NavinSiHive/Paper-to-Chip/README.md

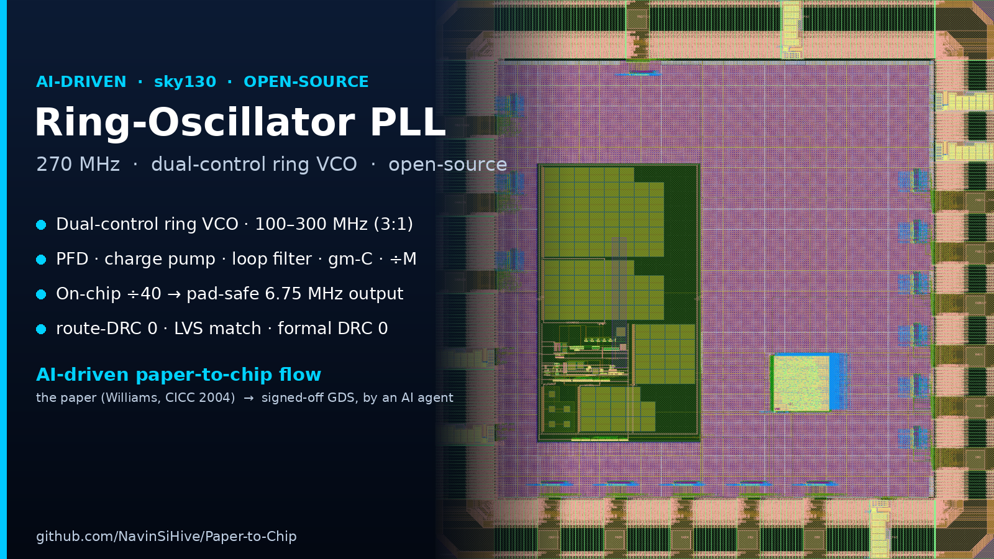
[picture p1: doc_images/pll_chip_banner.png]
Ring-Oscillator PLL — AI-driven paper-to-chip


# AI-driven Paper‑to‑Chip: an Open‑Source sky130 Ring‑Oscillator PLL






## 📖 The story behind this repo

We gave agentic AI a single input — a published IEEE PLL paper — and let it drive the
entire flow to a **clean sky130 mixed-signal chip**: circuit design, analog layout,
digital hardening (synth / STA / CTS / DFT), chip assembly, and DRC/LVS signoff. The
analog PLL macro (`PLLTOP4_D40`) **locks at 270 MHz across all corners with period
jitter under 5 ps**, DRC-clean and LVS-matched.

**→ Read the full write-up: https://si-hive.com/paper-to-chip**

**What's in here** (MIT-licensed): the chip and macro **GDS**, **behavioural + real-number
(RNM) models**, **schematics and symbols**, and the **signoff reports** (DRC / LVS / timing /
lock-detect). Study it, simulate the models (~2 min), reuse the blocks, retarget it to
another open PDK, or build on top — students, researchers, hobbyists, and startups welcome.

Built by **[Si-Hive](https://si-hive.com)** — AI-driven mixed-signal chip design.

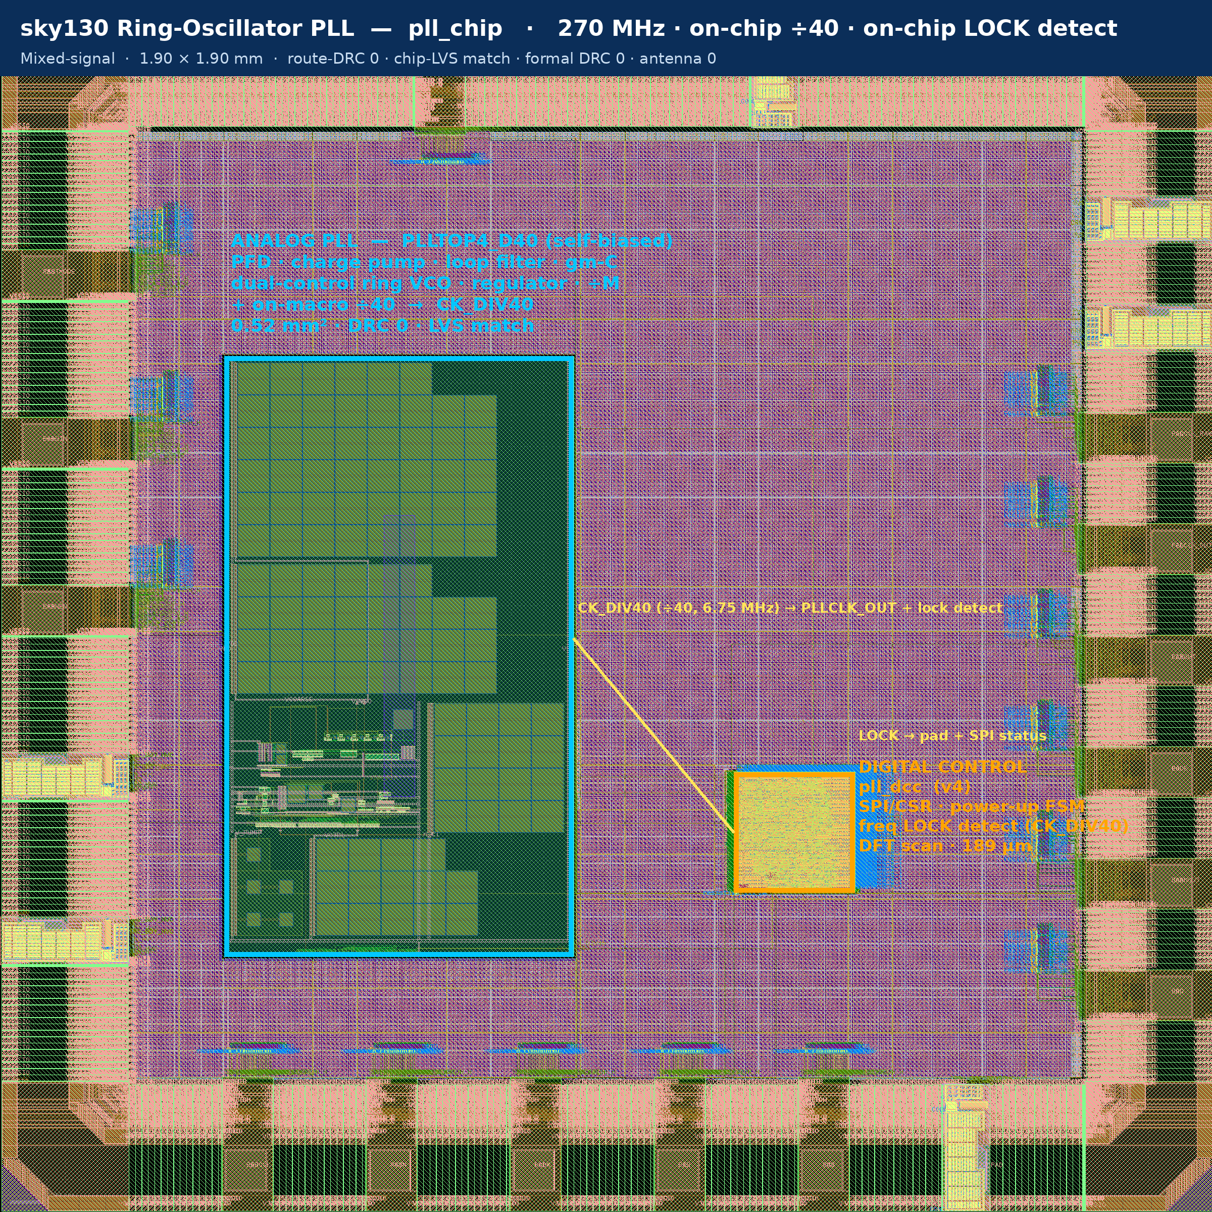
[picture p2: doc_images/pll_chip_snapshot.png]
PLL chip snapshot


*Final chip: self-biased analog PLL macro `PLLTOP4_D40` (left) + digital control `pll_dcc` (right) +
21‑pad IO ring. 1.90 × 1.90 mm, sky130. The analog macro divides its output by 40 on‑chip
(`CK_DIV40`, ~6.75 MHz) to a pad‑drivable rate.*

## Highlights
- **Full mixed‑signal chip**: analog PLL (PFD, charge pump, loop filter, gm‑C coarse path, dual‑control
  ring VCO, regulator, ÷M feedback) + a digital control/IO subsystem (SPI config, power‑up sequencing,
  lock detect, output‑clock management, DFT scan) + a sky130 pad ring.
- **Signed off**: route‑DRC 0 · chip‑LVS "match uniquely" · **formal DRC 0** (metal fill + standard
  hard‑IP waiver) · antenna 0 · multi‑corner STA clean (100–300 MHz).
- **On‑chip ÷40 output** (`CK_DIV40`): the ~270 MHz (≤300 MHz during lock) VCO clock is divided to
  ~6.75 MHz before the CMOS pad — sky130 has no LVDS, so the fast clock never leaves the analog.
- **Behavioral models included**: SystemVerilog (pre‑ and post‑layout) + a Real‑Number Model (RNM).

## Inside the analog PLL
The delivered analog macro **`PLLTOP4_D40`** is a self-biased **dual-control-path ring-oscillator PLL**
with an **on-chip ÷40** (pad-safe ≈ 6.75 MHz `CK_DIV40`). It builds up from the analog loop core outward —
**all three GDS are in [`gds/`](gds)** *(click any figure to zoom)*:

**`PLLTOP_AnaCore` — analog loop core** · the active devices: PFD · charge pump · ring VCO · ÷M · regulator · bias (loop-filter caps external).

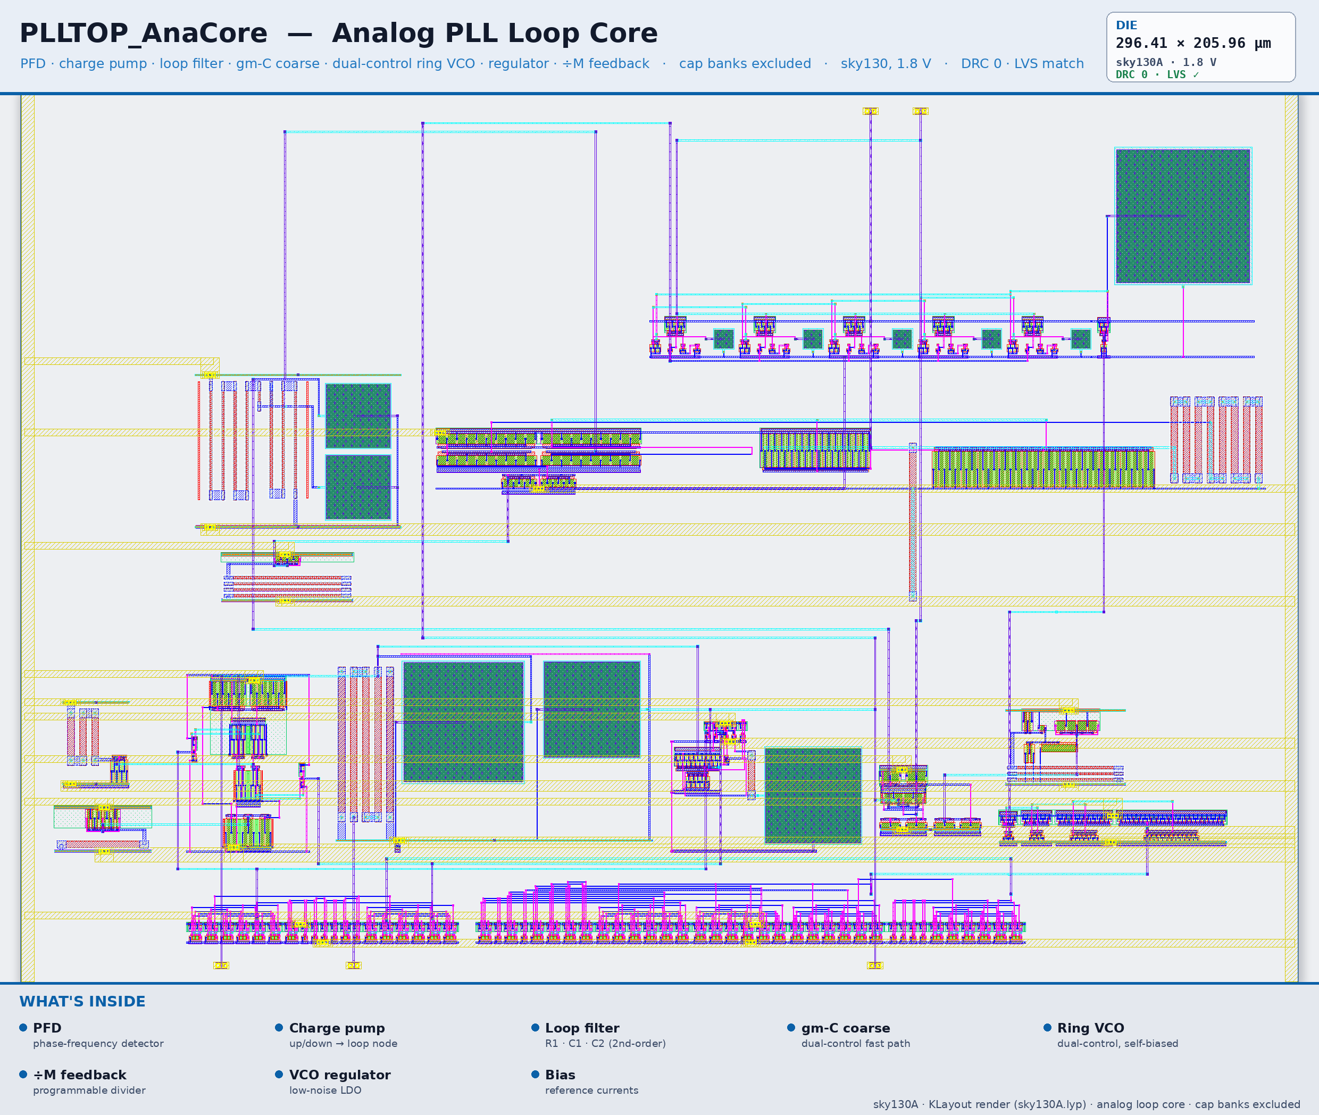
[picture p3: doc_images/PLLTOP_AnaCore.png]
PLLTOP_AnaCore


**`PLLTOP4` — PLL core** · the loop core plus the loop-filter / gm-C cap banks (no output divider).

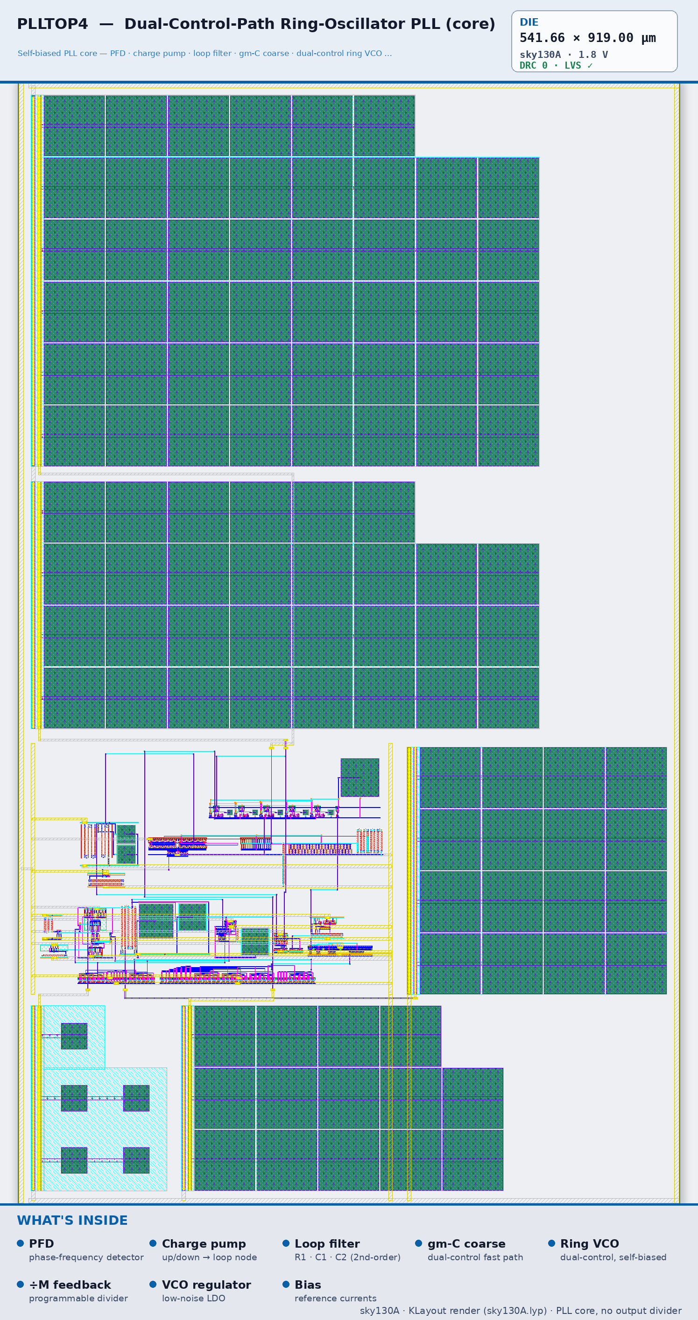
[picture p4: doc_images/PLLTOP4_layout.png]
PLLTOP4 core


**`PLLTOP4_D40` — delivered hard macro** · the PLL core + on-chip ÷40 (highlighted) → `CK_DIV40`.

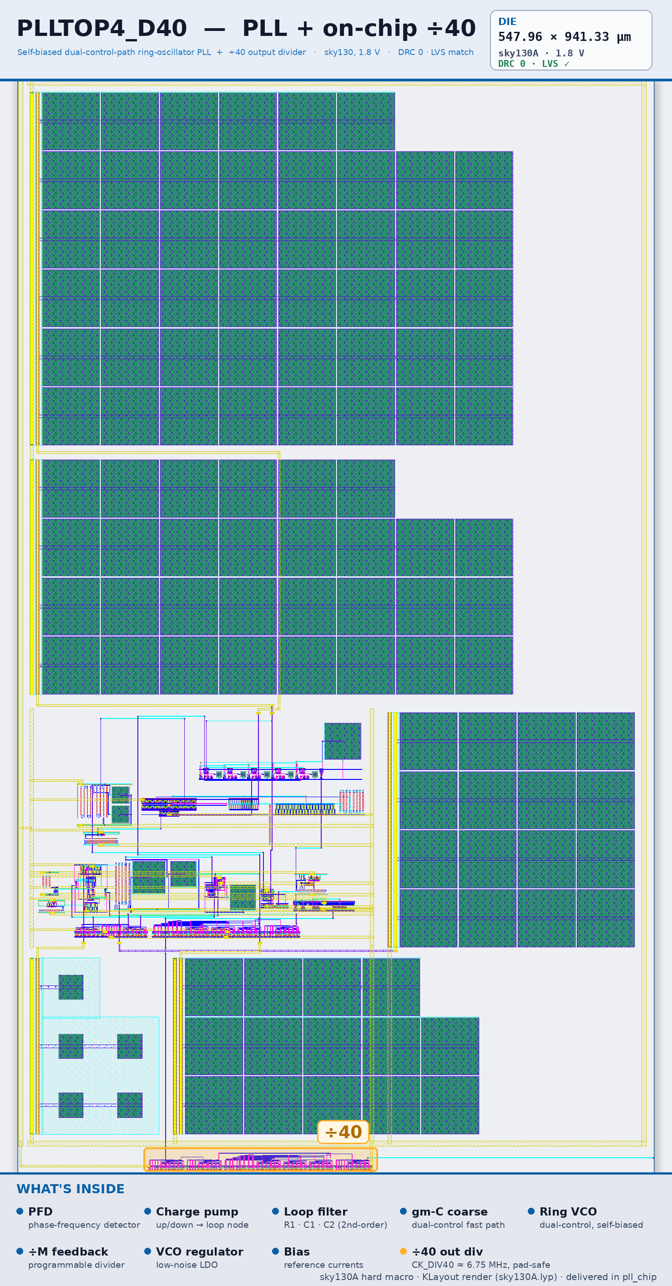
[picture p5: doc_images/PLLTOP4_D40_layout.png]
PLLTOP4_D40 macro


## Specs (nominal)
| Parameter | Value |
|---|---|
| Reference / output | 27 MHz → 270 MHz (÷M, M = 10) |
| Tuning range | 100 – 300 MHz (3:1, no band switching) |
| Output divider | ÷40 on‑macro → `CK_DIV40` ≈ 6.75 MHz |
| Supply / process | 1.8 V / sky130 (0.36 mm² analog, 1.90 × 1.90 mm chip) |

## Post-layout signoff (all corners)
| Corner | Lock | Period jitter (ps) |
|:---:|:---:|:---:|
| **TT** | 270 MHz | **1.96** |
| **SS** | 270 MHz | **0.60** |
| **FF** | 270 MHz | **2.30** |

All three corners lock at 270 MHz with period jitter **< 5 ps**.

### Lock witness — mixed-signal co-simulation
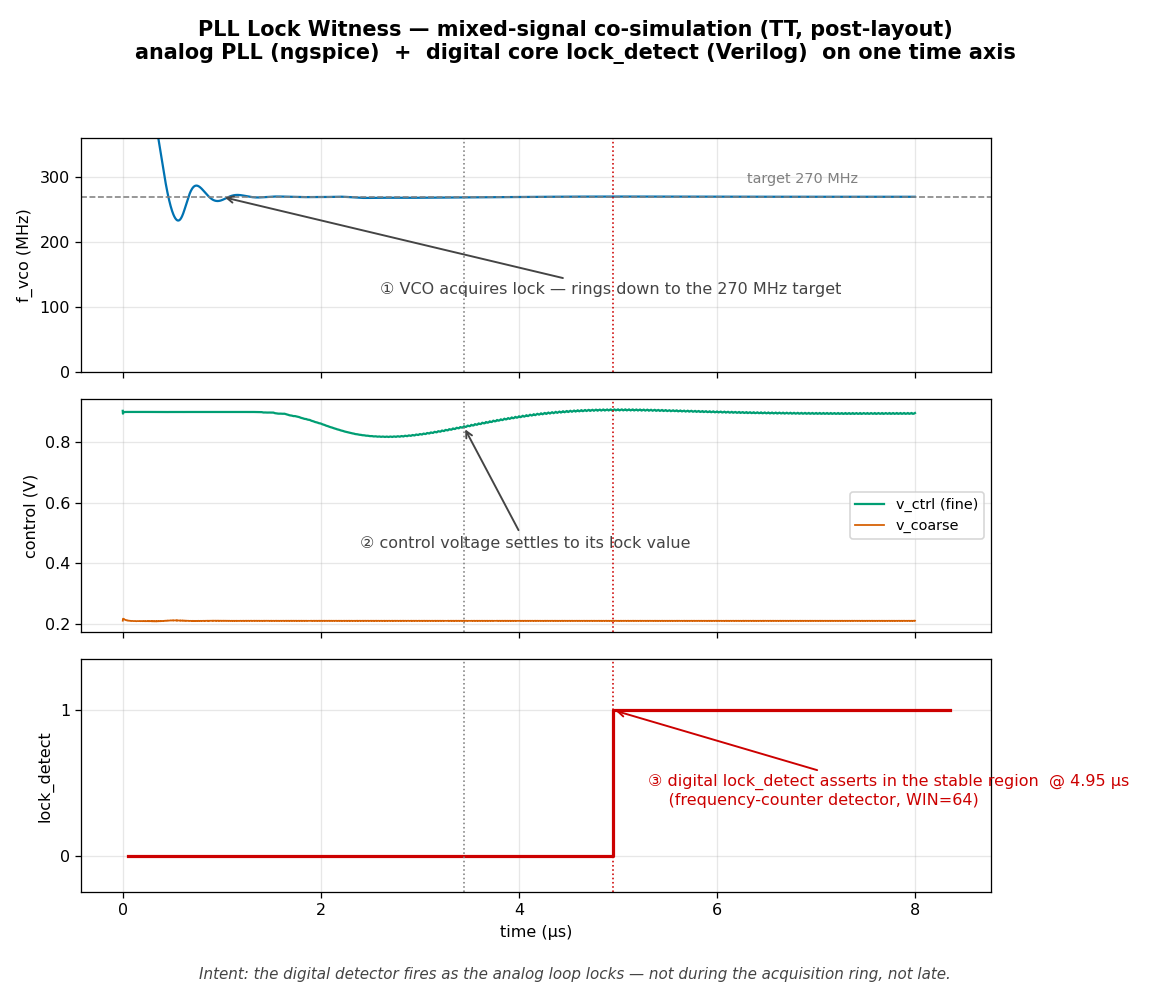
[picture p6: doc_images/pll_lock_witness.png]
PLL lock witness


*The analog PLL (ngspice) acquiring lock, with the digital core's `lock_detect` overlaid: `f_vco` rings
down to the 270 MHz target, the control voltage settles, and `lock_detect` asserts in the stable region
(~5 µs) — the digital detector witnessing the analog lock, on one time axis.*

## Repository layout
| Folder | Contents |
|---|---|
| [`gds/`](gds) | generated GDS (gz): chip · analog macro `PLLTOP4_D40` · PLL core `PLLTOP4` · loop core `PLLTOP_AnaCore` · digital core |
| [`schematics/`](schematics) | analog design schematics (xschem `.sch`) + device-level SPICE |
| [`symbols/`](symbols) | analog block symbols (xschem `.sym`) + macro abstracts (LEF) |
| [`models/`](models) | SystemVerilog (pre/post‑layout) + Real‑Number (RNM) models + testbench |
| [`cdl/`](cdl) | device‑level CDL / schematic netlists (for LVS) |
| [`reports/`](reports) | signoff reports — [`drc/`](reports/drc) · [`lvs/`](reports/lvs) · [`lock_detect/`](reports/lock_detect) · timing |
| [`docs/`](docs) | architecture, tapeout signoff summary |
| [`doc_images/`](doc_images) | chip + block layout images |

## Simulate the PLL model (2 minutes)
```bash
cd models && ./run_models.sh        # iverilog/Verilator: prelayout · postlayout · RNM → ALL_PASS
```
Checks: PLL_CLK locks to 270 MHz (±1 %), ÷M = 10.

## Use the GDS
```bash
gunzip gds/pll_chip.gds.gz          # open in KLayout / magic
```

## What is *not* here
The proprietary automated‑layout engine that generated the analog macro is intentionally excluded — this
repository ships the **generated artifacts** (GDS, models, docs) only. The analog PLL is delivered as a
verified hard macro.

## About & links
Built at **Si-Hive** — [si-hive.com](https://si-hive.com) · silicon design & EDA automation.

📖 **Full write-up:** [How this PLL went from paper to GDS with an AI design agent](https://si-hive.com/paper-to-chip)
— the corner results, the 100–300 MHz range, the lock-witness, and the open-source story.

💬 **Contact:** questions / collaboration → **assist@si-hive.com**, or open a GitHub issue.

## License
**MIT** (see [LICENSE](LICENSE)). Generated GDS, models, and docs are provided as‑is, without warranty.
