NavinSiHive/Paper-to-Chip/reports/lvs/README.md

# reports/lvs/
LVS reports. Chip-level hierarchical LVS (both macros black-boxed by port) = "Circuits match uniquely". Block-level LVS (PLLTOP_D40, pll_dcc) verified in their own flows.
