NavinSiHive/Paper-to-Chip/doc_images/phase3_ff_lock.png

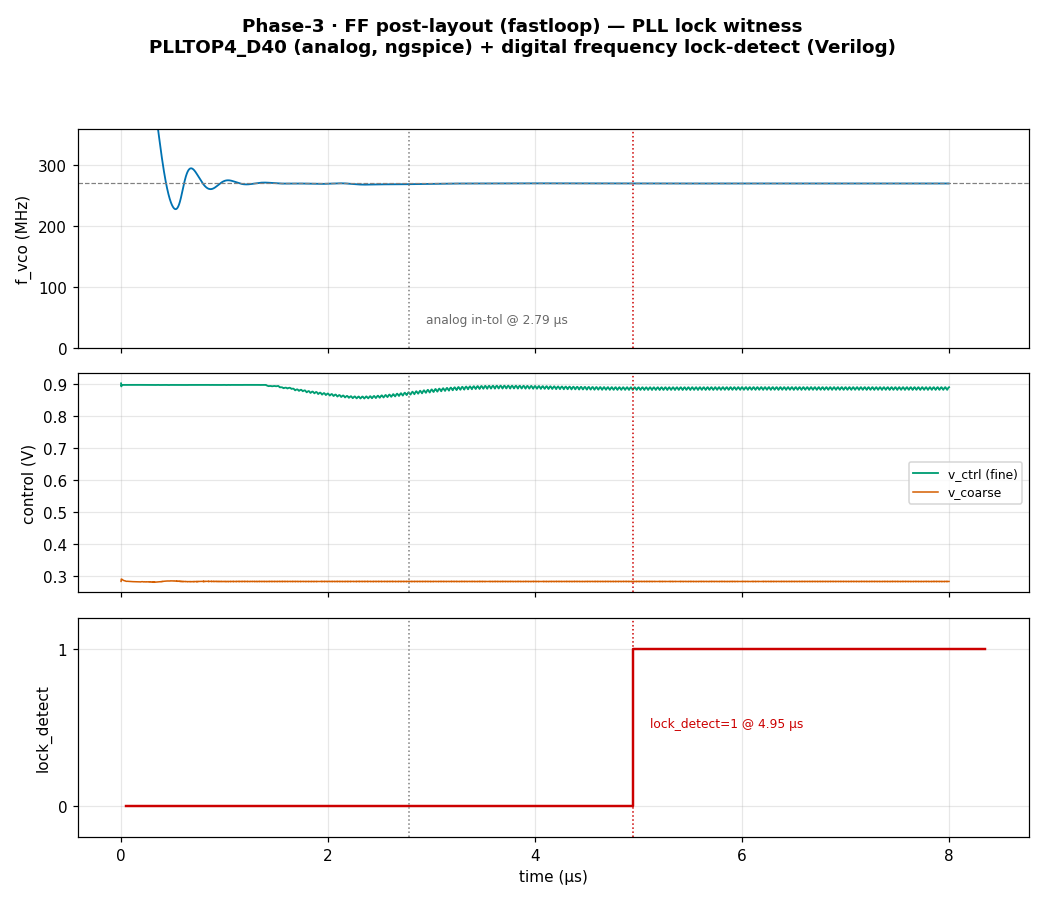
doc_images/phase3_ff_lock.png
