NavinSiHive/Paper-to-Chip/doc_images/phase3_ss_lock.png

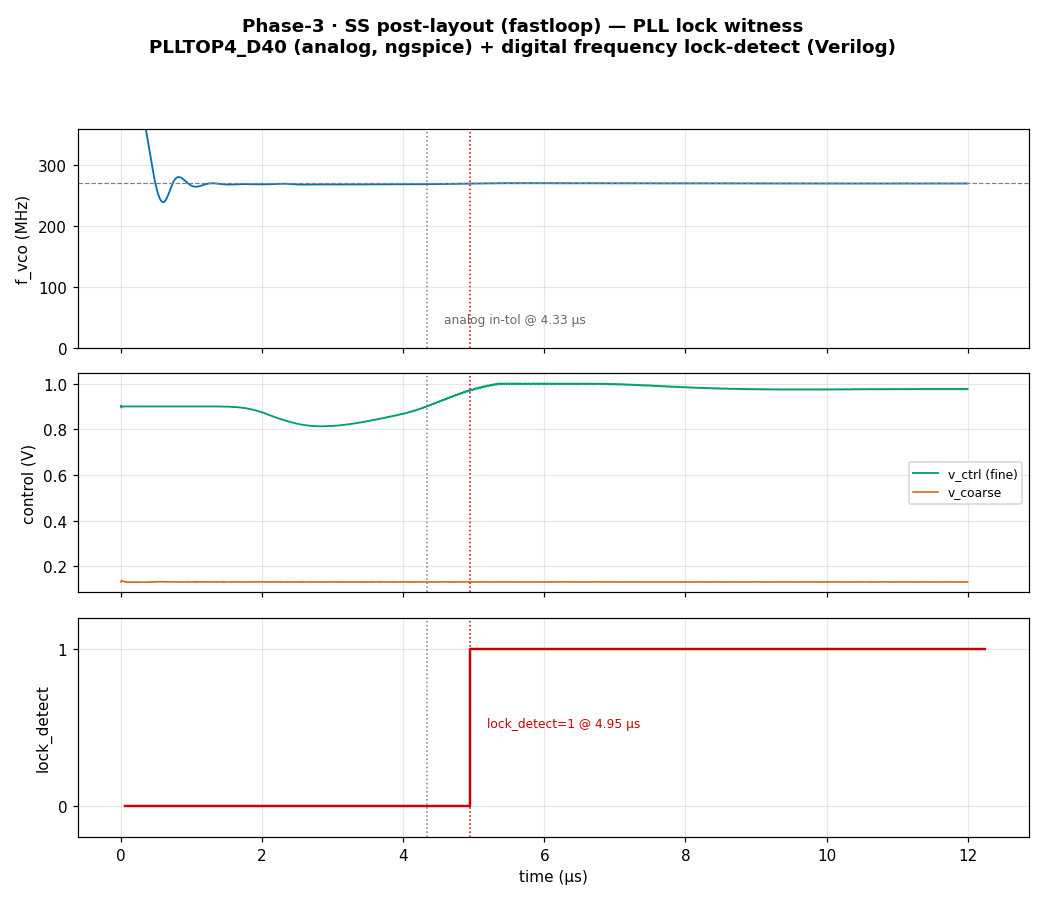
doc_images/phase3_ss_lock.png
