NavinSiHive/Paper-to-Chip/doc_images/phase3_tt_lock.png

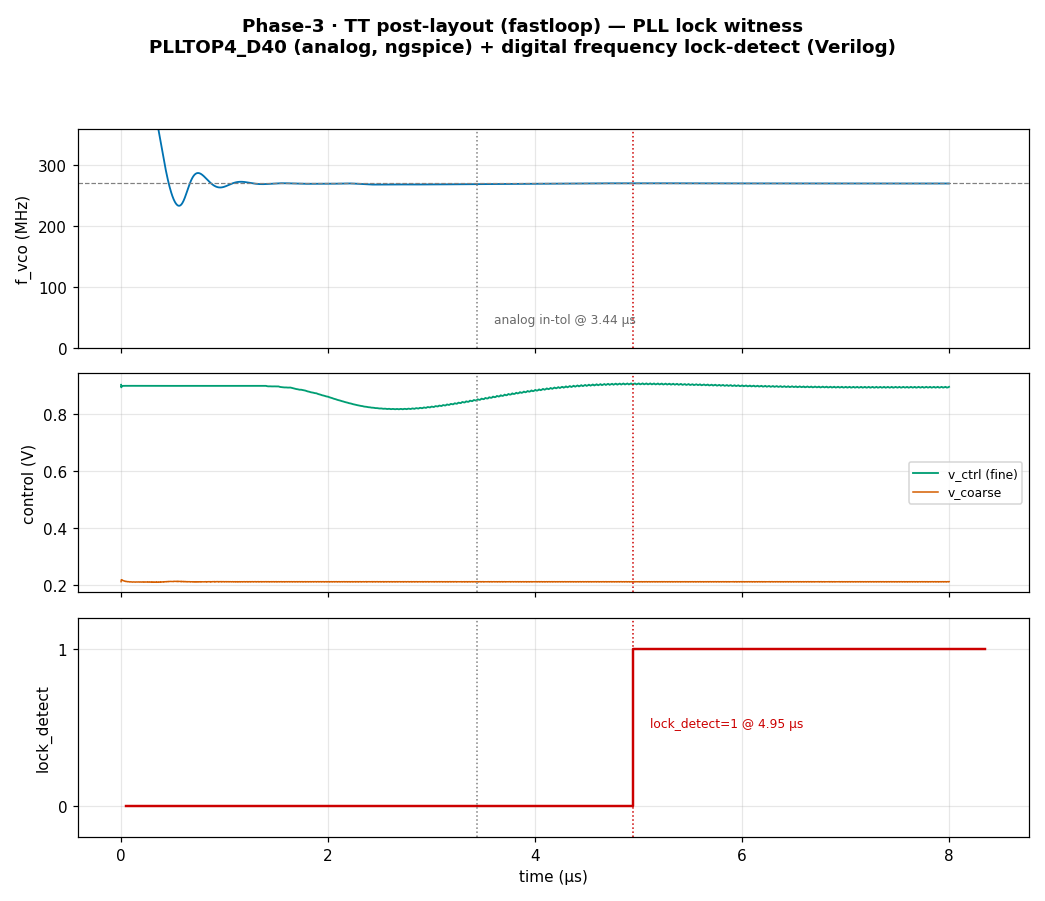
doc_images/phase3_tt_lock.png
