NavinSiHive/Paper-to-Chip/doc_images/pll_chip_final.png

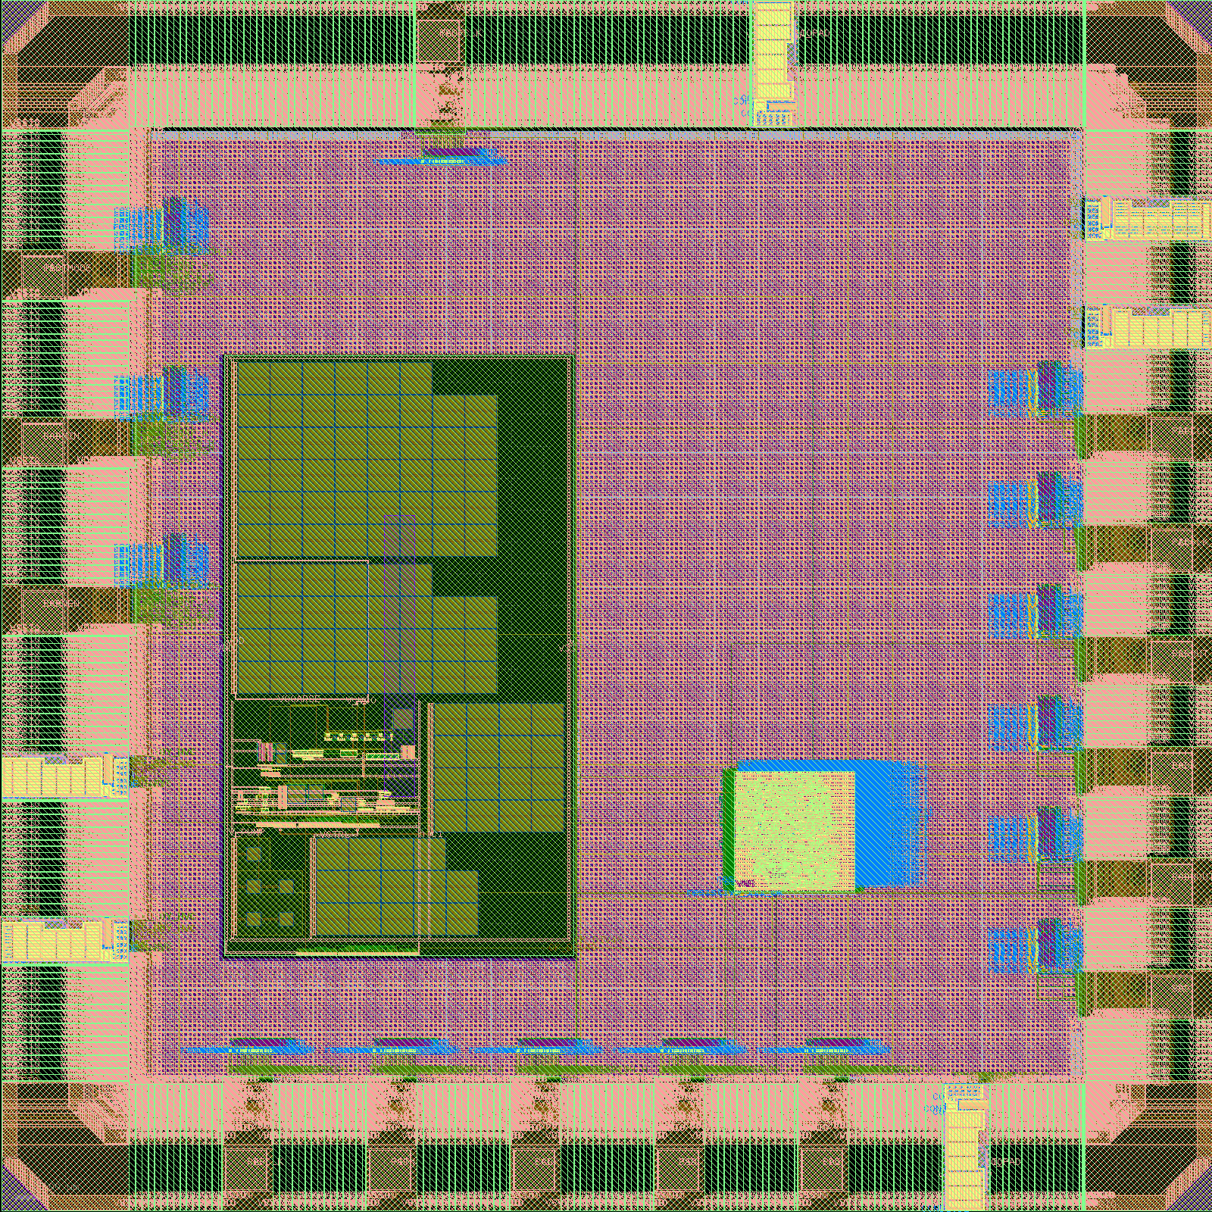
doc_images/pll_chip_final.png
