NavinSiHive/Paper-to-Chip/doc_images/pll_dcc_layout.png

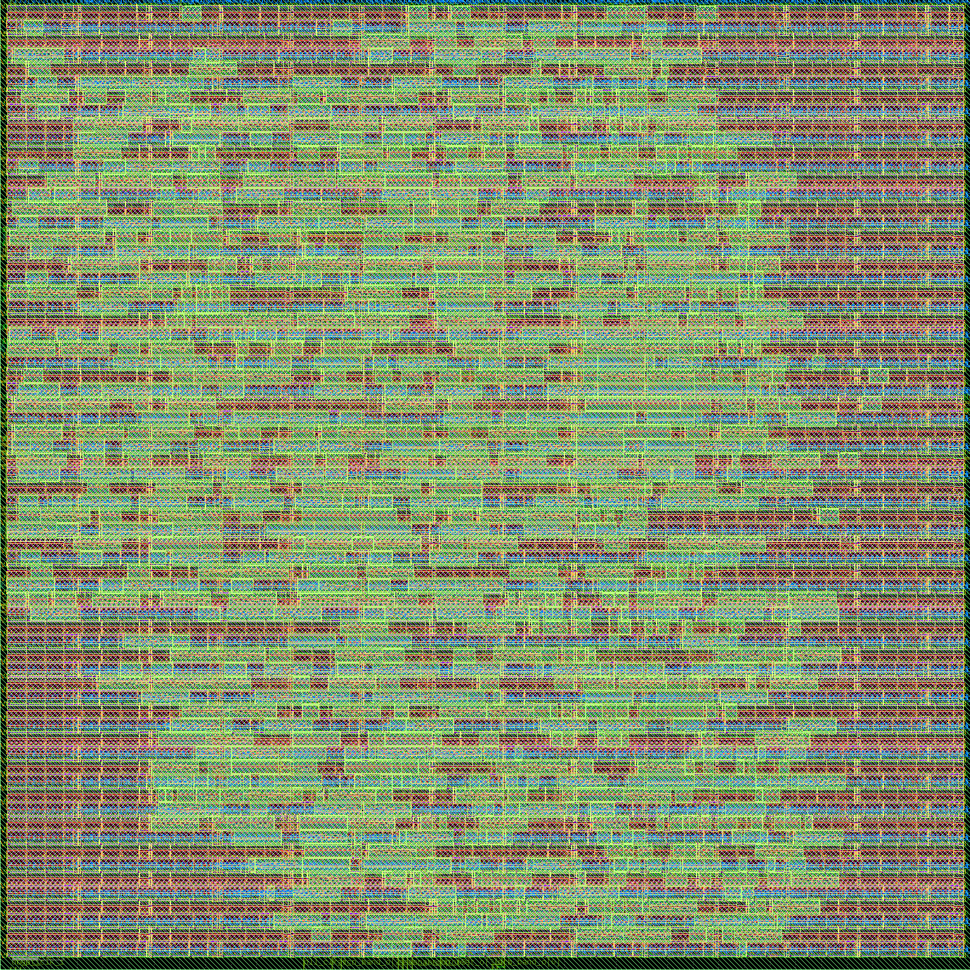
doc_images/pll_dcc_layout.png
