NavinSiHive/Paper-to-Chip/schematics/pll_dcc.gatelevel.v

module pll_dcc (clk_out_o,
    div_rst_o,
    dn_i,
    en_cp_o,
    en_vco_o,
    en_vreg_o,
    lock_o,
    pll_clk_i,
    pll_en_o,
    ref_o,
    refclk_i,
    rst_n_i,
    scan_en_i,
    scan_in_i,
    scan_out_o,
    spi_cs_n_i,
    spi_sclk_i,
    spi_sdi_i,
    spi_sdo_o,
    test_clk_i,
    test_mode_i,
    up_i,
    cp_iset_o,
    m_div_o,
    vco_band_o);
 output clk_out_o;
 output div_rst_o;
 input dn_i;
 output en_cp_o;
 output en_vco_o;
 output en_vreg_o;
 output lock_o;
 input pll_clk_i;
 output pll_en_o;
 output ref_o;
 input refclk_i;
 input rst_n_i;
 input scan_en_i;
 input scan_in_i;
 output scan_out_o;
 input spi_cs_n_i;
 input spi_sclk_i;
 input spi_sdi_i;
 output spi_sdo_o;
 input test_clk_i;
 input test_mode_i;
 input up_i;
 output [7:0] cp_iset_o;
 output [7:0] m_div_o;
 output [7:0] vco_band_o;

 wire pll_clk_i_regs;
 wire _0001_;
 wire _0002_;
 wire _0003_;
 wire _0004_;
 wire _0005_;
 wire _0006_;
 wire _0007_;
 wire _0008_;
 wire _0009_;
 wire _0010_;
 wire _0011_;
 wire _0012_;
 wire _0013_;
 wire _0014_;
 wire _0015_;
 wire _0016_;
 wire _0017_;
 wire _0018_;
 wire _0019_;
 wire _0020_;
 wire _0021_;
 wire _0022_;
 wire _0023_;
 wire _0024_;
 wire _0025_;
 wire _0026_;
 wire _0027_;
 wire _0028_;
 wire _0029_;
 wire _0030_;
 wire _0031_;
 wire _0032_;
 wire _0033_;
 wire _0034_;
 wire _0035_;
 wire _0036_;
 wire _0037_;
 wire _0038_;
 wire _0039_;
 wire _0040_;
 wire _0041_;
 wire _0042_;
 wire _0043_;
 wire _0044_;
 wire _0045_;
 wire _0046_;
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
 wire clknet_4_2_0_refclk_i_regs;
 wire clknet_4_3_0_refclk_i_regs;
 wire clknet_4_4_0_refclk_i_regs;
 wire clknet_4_5_0_refclk_i_regs;
 wire clknet_4_6_0_refclk_i_regs;
 wire clknet_4_7_0_refclk_i_regs;
 wire clknet_4_8_0_refclk_i_regs;
 wire clknet_4_9_0_refclk_i_regs;
 wire clknet_4_10_0_refclk_i_regs;
 wire clknet_4_11_0_refclk_i_regs;
 wire clknet_4_12_0_refclk_i_regs;
 wire clknet_4_13_0_refclk_i_regs;
 wire clknet_4_14_0_refclk_i_regs;
 wire clknet_4_15_0_refclk_i_regs;
 wire \clknet_0_u_clkout.sel_clk ;
 wire \clknet_1_0__leaf_u_clkout.sel_clk ;
 wire \clknet_0_u_clkout.sel_clk_regs ;
 wire \clknet_1_0__leaf_u_clkout.sel_clk_regs ;
 wire clknet_0_spi_sclk_i;
 wire clknet_3_0__leaf_spi_sclk_i;
 wire clknet_3_1__leaf_spi_sclk_i;
 wire clknet_3_2__leaf_spi_sclk_i;
 wire clknet_3_3__leaf_spi_sclk_i;
 wire clknet_3_4__leaf_spi_sclk_i;
 wire clknet_3_5__leaf_spi_sclk_i;
 wire clknet_3_6__leaf_spi_sclk_i;
 wire clknet_3_7__leaf_spi_sclk_i;
 wire clknet_0_pll_d2;
 wire clknet_1_0__leaf_pll_d2;
 wire clknet_1_1__leaf_pll_d2;
 wire delaynet_0_refclk;
 wire delaynet_1_refclk;
 wire delaynet_2_refclk;
 wire delaynet_3_refclk;
 wire delaynet_4_refclk;
 wire delaynet_5_refclk;
 wire delaynet_6_refclk;
 wire delaynet_7_refclk;

 sky130_fd_sc_hd__nand2_1 _0708_ (.A(\u_csr.bit_cnt[2] ),
    .B(_0012_),
    .Y(_0439_));
 sky130_fd_sc_hd__or2_2 _0709_ (.A(\u_csr.bit_cnt[3] ),
    .B(_0439_),
    .X(_0440_));
 sky130_fd_sc_hd__mux2_2 _0711_ (.A0(net6),
    .A1(net58),
    .S(_0440_),
    .X(_0190_));
 sky130_fd_sc_hd__mux2_2 _0714_ (.A0(\u_csr.shreg[0] ),
    .A1(\u_csr.addr_r[1] ),
    .S(_0440_),
    .X(_0189_));
 sky130_fd_sc_hd__mux2_2 _0716_ (.A0(\u_csr.shreg[1] ),
    .A1(\u_csr.addr_r[2] ),
    .S(_0440_),
    .X(_0188_));
 sky130_fd_sc_hd__mux2_2 _0718_ (.A0(\u_csr.shreg[2] ),
    .A1(\u_csr.addr_r[3] ),
    .S(_0440_),
    .X(_0187_));
 sky130_fd_sc_hd__mux2_2 _0720_ (.A0(\u_csr.shreg[3] ),
    .A1(\u_csr.addr_r[4] ),
    .S(_0440_),
    .X(_0186_));
 sky130_fd_sc_hd__mux2_2 _0722_ (.A0(\u_csr.shreg[4] ),
    .A1(\u_csr.addr_r[5] ),
    .S(_0440_),
    .X(_0185_));
 sky130_fd_sc_hd__inv_1 _0723_ (.A(\u_lock.bad_cnt[0] ),
    .Y(_0050_));
 sky130_fd_sc_hd__inv_1 _0724_ (.A(\u_clkout.N[2] ),
    .Y(_0014_));
 sky130_fd_sc_hd__inv_1 _0725_ (.A(\u_clkout.N[1] ),
    .Y(_0038_));
 sky130_fd_sc_hd__inv_1 _0726_ (.A(\u_lock.k_s[4] ),
    .Y(_0074_));
 sky130_fd_sc_hd__inv_1 _0727_ (.A(\u_lock.k_s[2] ),
    .Y(_0071_));
 sky130_fd_sc_hd__inv_1 _0728_ (.A(\u_lock.k_s[5] ),
    .Y(_0068_));
 sky130_fd_sc_hd__inv_1 _0729_ (.A(\u_lock.k_s[6] ),
    .Y(_0065_));
 sky130_fd_sc_hd__inv_1 _0730_ (.A(\c_seqdly[1] ),
    .Y(_0062_));
 sky130_fd_sc_hd__inv_1 _0731_ (.A(_0089_),
    .Y(_0448_));
 sky130_fd_sc_hd__nand2b_1 _0732_ (.A_N(_0033_),
    .B(_0032_),
    .Y(_0449_));
 sky130_fd_sc_hd__a21o_1 _0733_ (.A1(_0081_),
    .A2(_0449_),
    .B1(_0080_),
    .X(_0450_));
 sky130_fd_sc_hd__a21o_1 _0734_ (.A1(_0049_),
    .A2(_0450_),
    .B1(_0048_),
    .X(_0451_));
 sky130_fd_sc_hd__nor2_1 _0735_ (.A(_0448_),
    .B(_0451_),
    .Y(_0268_));
 sky130_fd_sc_hd__inv_1 _0736_ (.A(\u_clkout.cnt[0] ),
    .Y(_0030_));
 sky130_fd_sc_hd__nor2_1 _0737_ (.A(\u_clkout.cnt[0] ),
    .B(_0451_),
    .Y(_0267_));
 sky130_fd_sc_hd__nand3_1 _0738_ (.A(\u_csr.bit_cnt[2] ),
    .B(\u_csr.bit_cnt[1] ),
    .C(\u_csr.bit_cnt[0] ),
    .Y(_0452_));
 sky130_fd_sc_hd__xnor2_1 _0739_ (.A(\u_csr.bit_cnt[3] ),
    .B(_0452_),
    .Y(_0002_));
 sky130_fd_sc_hd__xor2_1 _0740_ (.A(\u_csr.bit_cnt[2] ),
    .B(_0013_),
    .X(_0001_));
 sky130_fd_sc_hd__nor3b_1 _0742_ (.A(\u_lock.win_cnt[14] ),
    .B(\u_lock.win_cnt[15] ),
    .C_N(_0017_),
    .Y(_0454_));
 sky130_fd_sc_hd__and3_1 _0743_ (.A(\u_lock.win_cnt[4] ),
    .B(\u_lock.win_cnt[3] ),
    .C(\u_lock.win_cnt[2] ),
    .X(_0455_));
 sky130_fd_sc_hd__and2_1 _0744_ (.A(\u_lock.win_cnt[5] ),
    .B(_0455_),
    .X(_0456_));
 sky130_fd_sc_hd__or4_1 _0745_ (.A(\u_lock.win_cnt[12] ),
    .B(\u_lock.win_cnt[13] ),
    .C(\u_lock.win_cnt[10] ),
    .D(\u_lock.win_cnt[11] ),
    .X(_0457_));
 sky130_fd_sc_hd__nand2_1 _0746_ (.A(\u_lock.win_cnt[7] ),
    .B(\u_lock.win_cnt[6] ),
    .Y(_0458_));
 sky130_fd_sc_hd__nor4_2 _0747_ (.A(\u_lock.win_cnt[9] ),
    .B(\u_lock.win_cnt[8] ),
    .C(_0457_),
    .D(_0458_),
    .Y(_0459_));
 sky130_fd_sc_hd__nand3_2 _0748_ (.A(_0454_),
    .B(_0456_),
    .C(_0459_),
    .Y(_0460_));
 sky130_fd_sc_hd__nand2_1 _0749_ (.A(\u_lock.u_en.q[0] ),
    .B(_0460_),
    .Y(_0461_));
 sky130_fd_sc_hd__nand2_1 _0752_ (.A(\u_lock.div_cnt[13] ),
    .B(\u_lock.div_cnt[12] ),
    .Y(_0464_));
 sky130_fd_sc_hd__and2_1 _0754_ (.A(\u_lock.div_cnt[11] ),
    .B(\u_lock.div_cnt[10] ),
    .X(_0466_));
 sky130_fd_sc_hd__and4_4 _0757_ (.A(\u_lock.div_cnt[5] ),
    .B(\u_lock.div_cnt[2] ),
    .C(\u_lock.div_cnt[4] ),
    .D(\u_lock.div_cnt[3] ),
    .X(_0469_));
 sky130_fd_sc_hd__and4_1 _0760_ (.A(\u_lock.div_cnt[6] ),
    .B(\u_lock.div_cnt[8] ),
    .C(\u_lock.div_cnt[7] ),
    .D(\u_lock.div_cnt[9] ),
    .X(_0472_));
 sky130_fd_sc_hd__nand4_4 _0761_ (.A(_0021_),
    .B(_0466_),
    .C(_0469_),
    .D(_0472_),
    .Y(_0473_));
 sky130_fd_sc_hd__nor2_1 _0762_ (.A(_0464_),
    .B(_0473_),
    .Y(_0474_));
 sky130_fd_sc_hd__xnor2_1 _0763_ (.A(\u_lock.div_cnt[14] ),
    .B(_0474_),
    .Y(_0475_));
 sky130_fd_sc_hd__nor2_1 _0764_ (.A(net54),
    .B(_0475_),
    .Y(_0284_));
 sky130_fd_sc_hd__nand4_1 _0765_ (.A(\u_lock.div_cnt[5] ),
    .B(\u_lock.div_cnt[2] ),
    .C(\u_lock.div_cnt[4] ),
    .D(\u_lock.div_cnt[3] ),
    .Y(_0476_));
 sky130_fd_sc_hd__nand2_1 _0766_ (.A(_0020_),
    .B(\u_lock.div_cnt[1] ),
    .Y(_0477_));
 sky130_fd_sc_hd__nor2_1 _0767_ (.A(_0476_),
    .B(_0477_),
    .Y(_0478_));
 sky130_fd_sc_hd__and4_1 _0768_ (.A(\u_lock.div_cnt[12] ),
    .B(_0466_),
    .C(_0472_),
    .D(_0478_),
    .X(_0479_));
 sky130_fd_sc_hd__xnor2_1 _0769_ (.A(\u_lock.div_cnt[13] ),
    .B(_0479_),
    .Y(_0480_));
 sky130_fd_sc_hd__nor2_1 _0770_ (.A(net54),
    .B(_0480_),
    .Y(_0283_));
 sky130_fd_sc_hd__xor2_1 _0771_ (.A(\u_lock.div_cnt[12] ),
    .B(_0473_),
    .X(_0481_));
 sky130_fd_sc_hd__nor2_1 _0772_ (.A(net54),
    .B(_0481_),
    .Y(_0282_));
 sky130_fd_sc_hd__nand3_1 _0773_ (.A(\u_lock.div_cnt[10] ),
    .B(_0472_),
    .C(_0478_),
    .Y(_0482_));
 sky130_fd_sc_hd__xor2_1 _0774_ (.A(\u_lock.div_cnt[11] ),
    .B(_0482_),
    .X(_0483_));
 sky130_fd_sc_hd__nor2_1 _0775_ (.A(net54),
    .B(_0483_),
    .Y(_0281_));
 sky130_fd_sc_hd__nand3_1 _0776_ (.A(_0021_),
    .B(_0469_),
    .C(_0472_),
    .Y(_0484_));
 sky130_fd_sc_hd__xor2_1 _0777_ (.A(\u_lock.div_cnt[10] ),
    .B(_0484_),
    .X(_0485_));
 sky130_fd_sc_hd__nor2_1 _0778_ (.A(net54),
    .B(_0485_),
    .Y(_0280_));
 sky130_fd_sc_hd__nand3_1 _0779_ (.A(\u_lock.div_cnt[6] ),
    .B(\u_lock.div_cnt[8] ),
    .C(\u_lock.div_cnt[7] ),
    .Y(_0486_));
 sky130_fd_sc_hd__and2_1 _0780_ (.A(_0020_),
    .B(\u_lock.div_cnt[1] ),
    .X(_0487_));
 sky130_fd_sc_hd__nand2_1 _0781_ (.A(_0469_),
    .B(_0487_),
    .Y(_0488_));
 sky130_fd_sc_hd__nor2_1 _0782_ (.A(_0486_),
    .B(_0488_),
    .Y(_0489_));
 sky130_fd_sc_hd__xnor2_1 _0783_ (.A(\u_lock.div_cnt[9] ),
    .B(_0489_),
    .Y(_0490_));
 sky130_fd_sc_hd__nor2_1 _0784_ (.A(net54),
    .B(_0490_),
    .Y(_0294_));
 sky130_fd_sc_hd__and2_1 _0785_ (.A(_0021_),
    .B(_0469_),
    .X(_0491_));
 sky130_fd_sc_hd__nand3_1 _0786_ (.A(\u_lock.div_cnt[6] ),
    .B(\u_lock.div_cnt[7] ),
    .C(_0491_),
    .Y(_0492_));
 sky130_fd_sc_hd__xor2_1 _0787_ (.A(\u_lock.div_cnt[8] ),
    .B(_0492_),
    .X(_0493_));
 sky130_fd_sc_hd__nor2_1 _0788_ (.A(net54),
    .B(_0493_),
    .Y(_0293_));
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
    .B(_0525_),
    .Y(_0309_));
 sky130_fd_sc_hd__nand2_1 _0836_ (.A(\u_lock.win_cnt[6] ),
    .B(_0513_),
    .Y(_0526_));
 sky130_fd_sc_hd__xor2_1 _0837_ (.A(\u_lock.win_cnt[7] ),
    .B(_0526_),
    .X(_0527_));
 sky130_fd_sc_hd__nor2_1 _0838_ (.A(net54),
    .B(_0527_),
    .Y(_0308_));
 sky130_fd_sc_hd__xor2_1 _0839_ (.A(\u_lock.win_cnt[6] ),
    .B(_0507_),
    .X(_0528_));
 sky130_fd_sc_hd__nor2_1 _0840_ (.A(net54),
    .B(_0528_),
    .Y(_0307_));
 sky130_fd_sc_hd__nand3_1 _0841_ (.A(\u_lock.win_cnt[0] ),
    .B(\u_lock.win_cnt[1] ),
    .C(_0455_),
    .Y(_0529_));
 sky130_fd_sc_hd__xor2_1 _0842_ (.A(\u_lock.win_cnt[5] ),
    .B(_0529_),
    .X(_0530_));
 sky130_fd_sc_hd__nor2_1 _0843_ (.A(_0461_),
    .B(_0530_),
    .Y(_0306_));
 sky130_fd_sc_hd__nand3_1 _0844_ (.A(\u_lock.win_cnt[3] ),
    .B(_0019_),
    .C(\u_lock.win_cnt[2] ),
    .Y(_0531_));
 sky130_fd_sc_hd__xor2_1 _0845_ (.A(\u_lock.win_cnt[4] ),
    .B(_0531_),
    .X(_0532_));
 sky130_fd_sc_hd__nor2_1 _0846_ (.A(_0461_),
    .B(_0532_),
    .Y(_0305_));
 sky130_fd_sc_hd__nand3_1 _0847_ (.A(\u_lock.win_cnt[2] ),
    .B(\u_lock.win_cnt[0] ),
    .C(\u_lock.win_cnt[1] ),
    .Y(_0533_));
 sky130_fd_sc_hd__xor2_1 _0848_ (.A(\u_lock.win_cnt[3] ),
    .B(_0533_),
    .X(_0534_));
 sky130_fd_sc_hd__nor2_1 _0849_ (.A(_0461_),
    .B(_0534_),
    .Y(_0304_));
 sky130_fd_sc_hd__xnor2_1 _0850_ (.A(_0019_),
    .B(\u_lock.win_cnt[2] ),
    .Y(_0535_));
 sky130_fd_sc_hd__nor2_1 _0851_ (.A(_0461_),
    .B(_0535_),
    .Y(_0303_));
 sky130_fd_sc_hd__and3_1 _0852_ (.A(\u_lock.u_en.q[0] ),
    .B(_0018_),
    .C(_0460_),
    .X(_0302_));
 sky130_fd_sc_hd__nor2_1 _0853_ (.A(\u_lock.win_cnt[0] ),
    .B(_0461_),
    .Y(_0295_));
 sky130_fd_sc_hd__inv_1 _0854_ (.A(\u_lock.good_cnt[0] ),
    .Y(_0006_));
 sky130_fd_sc_hd__inv_1 _0855_ (.A(\u_seq.dwell[0] ),
    .Y(_0028_));
 sky130_fd_sc_hd__inv_1 _0856_ (.A(\c_seqdly[4] ),
    .Y(_0077_));
 sky130_fd_sc_hd__inv_1 _0857_ (.A(\u_lock.k_s[3] ),
    .Y(_0003_));
 sky130_fd_sc_hd__xnor2_1 _0858_ (.A(\u_clkout.N[2] ),
    .B(_0042_),
    .Y(_0047_));
 sky130_fd_sc_hd__and4_1 _0859_ (.A(net58),
    .B(\u_csr.addr_r[1] ),
    .C(\u_csr.addr_r[5] ),
    .D(\u_csr.addr_r[6] ),
    .X(_0536_));
 sky130_fd_sc_hd__nand4_1 _0860_ (.A(\u_csr.addr_r[2] ),
    .B(\u_csr.addr_r[3] ),
    .C(\u_csr.addr_r[4] ),
    .D(_0536_),
    .Y(_0537_));
 sky130_fd_sc_hd__or3_4 _0861_ (.A(\u_csr.addr_r[4] ),
    .B(\u_csr.addr_r[5] ),
    .C(\u_csr.addr_r[6] ),
    .X(_0538_));
 sky130_fd_sc_hd__o21ai_0 _0862_ (.A1(net57),
    .A2(\u_csr.addr_r[2] ),
    .B1(\u_csr.addr_r[3] ),
    .Y(_0539_));
 sky130_fd_sc_hd__nand2b_1 _0863_ (.A_N(_0538_),
    .B(_0539_),
    .Y(_0540_));
 sky130_fd_sc_hd__nand3b_1 _0864_ (.A_N(\u_csr.bit_cnt[2] ),
    .B(_0011_),
    .C(\u_csr.bit_cnt[3] ),
    .Y(_0541_));
 sky130_fd_sc_hd__a21oi_1 _0865_ (.A1(_0537_),
    .A2(_0540_),
    .B1(_0541_),
    .Y(_0542_));
 sky130_fd_sc_hd__inv_1 _0866_ (.A(_0542_),
    .Y(_0543_));
 sky130_fd_sc_hd__nor2b_1 _0867_ (.A(net57),
    .B_N(net58),
    .Y(_0544_));
 sky130_fd_sc_hd__nor2_1 _0868_ (.A(\u_csr.addr_r[2] ),
    .B(_0538_),
    .Y(_0545_));
 sky130_fd_sc_hd__and3_1 _0869_ (.A(\u_csr.addr_r[3] ),
    .B(_0544_),
    .C(_0545_),
    .X(_0546_));
 sky130_fd_sc_hd__nor3_4 _0871_ (.A(\u_csr.addr_r[2] ),
    .B(\u_csr.addr_r[3] ),
    .C(_0538_),
    .Y(_0548_));
 sky130_fd_sc_hd__mux4_2 _0874_ (.A0(\u_csr.r_ctrl[6] ),
    .A1(\u_csr.r_ens[6] ),
    .A2(\u_csr.r_mdiv[6] ),
    .A3(\u_csr.r_odiv[6] ),
    .S0(net58),
    .S1(net57),
    .X(_0551_));
 sky130_fd_sc_hd__nor3b_2 _0875_ (.A(\u_csr.addr_r[3] ),
    .B(_0538_),
    .C_N(\u_csr.addr_r[2] ),
    .Y(_0552_));
 sky130_fd_sc_hd__mux4_2 _0876_ (.A0(\u_csr.r_cpiset[6] ),
    .A1(\u_csr.r_vcobnd[6] ),
    .A2(\u_csr.r_lockw[6] ),
    .A3(\u_csr.r_seqdly[6] ),
    .S0(\u_csr.addr_r[0] ),
    .S1(net57),
    .X(_0553_));
 sky130_fd_sc_hd__a22o_1 _0877_ (.A1(_0548_),
    .A2(_0551_),
    .B1(_0552_),
    .B2(_0553_),
    .X(_0554_));
 sky130_fd_sc_hd__a21oi_1 _0878_ (.A1(\u_csr.r_test[6] ),
    .A2(_0546_),
    .B1(_0554_),
    .Y(_0555_));
 sky130_fd_sc_hd__nand2_1 _0879_ (.A(\u_csr.sh_out[5] ),
    .B(_0541_),
    .Y(_0556_));
 sky130_fd_sc_hd__o21ai_0 _0880_ (.A1(_0543_),
    .A2(_0555_),
    .B1(_0556_),
    .Y(_0277_));
 sky130_fd_sc_hd__mux4_2 _0881_ (.A0(\u_csr.r_ctrl[5] ),
    .A1(\u_csr.r_ens[5] ),
    .A2(\u_csr.r_mdiv[5] ),
    .A3(\u_csr.r_odiv[5] ),
    .S0(\u_csr.addr_r[0] ),
    .S1(net57),
    .X(_0557_));
 sky130_fd_sc_hd__mux4_2 _0882_ (.A0(\u_csr.r_cpiset[5] ),
    .A1(\u_csr.r_vcobnd[5] ),
    .A2(\u_csr.r_lockw[5] ),
    .A3(\u_csr.r_seqdly[5] ),
    .S0(\u_csr.addr_r[0] ),
    .S1(net57),
    .X(_0558_));
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
    .A1(\u_csr.r_lockw[0] ),
    .S(_0609_),
    .X(_0184_));
 sky130_fd_sc_hd__or2_2 _1035_ (.A(\u_lock.div_cnt[14] ),
    .B(\u_lock.div_cnt[15] ),
    .X(_0610_));
 sky130_fd_sc_hd__o21ai_0 _1036_ (.A1(_0476_),
    .A2(_0477_),
    .B1(\u_lock.div_cnt[15] ),
    .Y(_0611_));
 sky130_fd_sc_hd__or3_1 _1037_ (.A(\u_lock.div_cnt[15] ),
    .B(_0476_),
    .C(_0477_),
    .X(_0612_));
 sky130_fd_sc_hd__nand3_1 _1038_ (.A(\u_lock.div_cnt[14] ),
    .B(_0611_),
    .C(_0612_),
    .Y(_0613_));
 sky130_fd_sc_hd__mux2i_1 _1039_ (.A0(_0610_),
    .A1(_0613_),
    .S(_0474_),
    .Y(_0614_));
 sky130_fd_sc_hd__nand3b_1 _1040_ (.A_N(\u_lock.div_cnt[2] ),
    .B(_0021_),
    .C(\u_lock.div_cnt[3] ),
    .Y(_0615_));
 sky130_fd_sc_hd__a21boi_0 _1041_ (.A1(_0020_),
    .A2(\u_lock.div_cnt[1] ),
    .B1_N(\u_lock.div_cnt[3] ),
    .Y(_0616_));
 sky130_fd_sc_hd__and3b_1 _1042_ (.A_N(\u_lock.div_cnt[3] ),
    .B(\u_lock.div_cnt[1] ),
    .C(_0020_),
    .X(_0617_));
 sky130_fd_sc_hd__nor2b_1 _1043_ (.A(_0021_),
    .B_N(\u_lock.div_cnt[2] ),
    .Y(_0618_));
 sky130_fd_sc_hd__o21ai_0 _1044_ (.A1(_0616_),
    .A2(_0617_),
    .B1(_0618_),
    .Y(_0619_));
 sky130_fd_sc_hd__o211ai_1 _1045_ (.A1(\u_lock.div_total[1] ),
    .A2(\u_lock.div_total[0] ),
    .B1(\u_lock.div_cnt[4] ),
    .C1(\u_lock.div_cnt[5] ),
    .Y(_0620_));
 sky130_fd_sc_hd__a21oi_1 _1046_ (.A1(_0615_),
    .A2(_0619_),
    .B1(_0620_),
    .Y(_0621_));
 sky130_fd_sc_hd__and2_1 _1047_ (.A(\u_lock.div_cnt[2] ),
    .B(_0021_),
    .X(_0622_));
 sky130_fd_sc_hd__nor2_1 _1048_ (.A(\u_lock.div_cnt[2] ),
    .B(_0021_),
    .Y(_0623_));
 sky130_fd_sc_hd__a21oi_1 _1049_ (.A1(_0477_),
    .A2(_0622_),
    .B1(_0623_),
    .Y(_0624_));
 sky130_fd_sc_hd__or3_1 _1050_ (.A(\u_lock.div_cnt[5] ),
    .B(\u_lock.div_cnt[4] ),
    .C(\u_lock.div_cnt[3] ),
    .X(_0625_));
 sky130_fd_sc_hd__nor4b_1 _1051_ (.A(\u_lock.div_cnt[6] ),
    .B(_0487_),
    .C(_0476_),
    .D_N(_0021_),
    .Y(_0626_));
 sky130_fd_sc_hd__a21boi_0 _1052_ (.A1(_0021_),
    .A2(_0469_),
    .B1_N(\u_lock.div_cnt[6] ),
    .Y(_0627_));
 sky130_fd_sc_hd__o22ai_1 _1053_ (.A1(_0624_),
    .A2(_0625_),
    .B1(_0626_),
    .B2(_0627_),
    .Y(_0628_));
 sky130_fd_sc_hd__a21o_1 _1054_ (.A1(_0020_),
    .A2(\u_lock.div_cnt[1] ),
    .B1(_0021_),
    .X(_0629_));
 sky130_fd_sc_hd__a31o_1 _1055_ (.A1(\u_lock.div_cnt[6] ),
    .A2(_0469_),
    .A3(_0629_),
    .B1(\u_lock.div_cnt[7] ),
    .X(_0630_));
 sky130_fd_sc_hd__nor2b_1 _1056_ (.A(_0021_),
    .B_N(\u_lock.div_cnt[7] ),
    .Y(_0631_));
 sky130_fd_sc_hd__nand4_1 _1057_ (.A(\u_lock.div_cnt[6] ),
    .B(_0469_),
    .C(_0487_),
    .D(_0631_),
    .Y(_0632_));
 sky130_fd_sc_hd__a211oi_2 _1058_ (.A1(_0630_),
    .A2(_0632_),
    .B1(\u_lock.div_cnt[8] ),
    .C1(\u_lock.div_cnt[9] ),
    .Y(_0633_));
 sky130_fd_sc_hd__o311a_2 _1059_ (.A1(\u_lock.div_cnt[6] ),
    .A2(_0491_),
    .A3(_0621_),
    .B1(_0628_),
    .C1(_0633_),
    .X(_0634_));
 sky130_fd_sc_hd__nor2_1 _1060_ (.A(\u_lock.div_cnt[13] ),
    .B(\u_lock.div_cnt[11] ),
    .Y(_0635_));
 sky130_fd_sc_hd__o21ai_0 _1061_ (.A1(_0476_),
    .A2(_0477_),
    .B1(\u_lock.div_cnt[10] ),
    .Y(_0636_));
 sky130_fd_sc_hd__mux2i_1 _1062_ (.A0(_0636_),
    .A1(\u_lock.div_cnt[10] ),
    .S(_0484_),
    .Y(_0637_));
 sky130_fd_sc_hd__o21ai_0 _1063_ (.A1(_0476_),
    .A2(_0477_),
    .B1(\u_lock.div_cnt[12] ),
    .Y(_0638_));
 sky130_fd_sc_hd__mux2i_1 _1064_ (.A0(_0638_),
    .A1(\u_lock.div_cnt[12] ),
    .S(_0473_),
    .Y(_0639_));
 sky130_fd_sc_hd__and3_1 _1065_ (.A(\u_lock.div_cnt[14] ),
    .B(\u_lock.div_cnt[15] ),
    .C(_0466_),
    .X(_0640_));
 sky130_fd_sc_hd__nor4_2 _1066_ (.A(_0464_),
    .B(_0473_),
    .C(_0488_),
    .D(_0640_),
    .Y(_0641_));
 sky130_fd_sc_hd__a31o_2 _1067_ (.A1(_0635_),
    .A2(_0637_),
    .A3(_0639_),
    .B1(_0641_),
    .X(_0642_));
 sky130_fd_sc_hd__nand3_4 _1068_ (.A(_0614_),
    .B(_0634_),
    .C(_0642_),
    .Y(_0643_));
 sky130_fd_sc_hd__nor2_1 _1069_ (.A(_0460_),
    .B(_0643_),
    .Y(_0644_));
 sky130_fd_sc_hd__clkinv_1 _1070_ (.A(\u_lock.u_en.q[0] ),
    .Y(_0645_));
 sky130_fd_sc_hd__nand2_1 _1071_ (.A(\u_lock.good_cnt[5] ),
    .B(\u_lock.good_cnt[4] ),
    .Y(_0646_));
 sky130_fd_sc_hd__nand3_1 _1072_ (.A(_0022_),
    .B(\u_lock.good_cnt[3] ),
    .C(\u_lock.good_cnt[2] ),
    .Y(_0647_));
 sky130_fd_sc_hd__a2111o_1 _1073_ (.A1(_0070_),
    .A2(_0075_),
    .B1(_0069_),
    .C1(_0057_),
    .D1(_0066_),
    .X(_0648_));
 sky130_fd_sc_hd__inv_1 _1074_ (.A(_0007_),
    .Y(_0649_));
 sky130_fd_sc_hd__o21ai_0 _1075_ (.A1(_0649_),
    .A2(_0008_),
    .B1(_0087_),
    .Y(_0650_));
 sky130_fd_sc_hd__nor2_1 _1076_ (.A(_0072_),
    .B(_0086_),
    .Y(_0651_));
 sky130_fd_sc_hd__o21ai_0 _1077_ (.A1(_0072_),
    .A2(_0073_),
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
    .D(_0362_),
    .Y(_0368_));
 sky130_fd_sc_hd__a21oi_1 _1207_ (.A1(_0367_),
    .A2(_0368_),
    .B1(_0645_),
    .Y(_0224_));
 sky130_fd_sc_hd__o21ai_0 _1208_ (.A1(_0460_),
    .A2(_0364_),
    .B1(\u_lock.bad_cnt[0] ),
    .Y(_0369_));
 sky130_fd_sc_hd__nand4_1 _1209_ (.A(_0050_),
    .B(_0665_),
    .C(_0643_),
    .D(_0362_),
    .Y(_0370_));
 sky130_fd_sc_hd__a21oi_1 _1210_ (.A1(_0369_),
    .A2(_0370_),
    .B1(_0645_),
    .Y(_0225_));
 sky130_fd_sc_hd__inv_1 _1211_ (.A(\c_seqdly[5] ),
    .Y(_0034_));
 sky130_fd_sc_hd__inv_1 _1212_ (.A(\u_lock.k_s[7] ),
    .Y(_0056_));
 sky130_fd_sc_hd__inv_1 _1213_ (.A(\c_seqdly[7] ),
    .Y(_0044_));
 sky130_fd_sc_hd__inv_1 _1214_ (.A(\c_seqdly[3] ),
    .Y(_0039_));
 sky130_fd_sc_hd__inv_1 _1215_ (.A(\c_seqdly[0] ),
    .Y(_0026_));
 sky130_fd_sc_hd__nor2_1 _1216_ (.A(_0460_),
    .B(_0362_),
    .Y(_0371_));
 sky130_fd_sc_hd__a41oi_1 _1217_ (.A1(\u_lock.u_en.q[0] ),
    .A2(\u_lock.u_lk.d[0] ),
    .A3(_0643_),
    .A4(_0371_),
    .B1(\u_lock.u_ll.d[0] ),
    .Y(_0372_));
 sky130_fd_sc_hd__xor2_1 _1218_ (.A(\u_lock.u_clr.s[2] ),
    .B(\u_lock.u_clr.s[1] ),
    .X(_0373_));
 sky130_fd_sc_hd__nor2_1 _1219_ (.A(_0372_),
    .B(_0373_),
    .Y(_0226_));
 sky130_fd_sc_hd__xnor2_1 _1220_ (.A(\u_csr.u_clr.s[2] ),
    .B(\u_csr.u_clr.s[1] ),
    .Y(_0374_));
 sky130_fd_sc_hd__xnor2_1 _1221_ (.A(\u_lock.u_clr.tog ),
    .B(_0374_),
    .Y(_0227_));
 sky130_fd_sc_hd__mux2_2 _1222_ (.A0(net32),
    .A1(net4),
    .S(net3),
    .X(_0228_));
 sky130_fd_sc_hd__nand4_1 _1223_ (.A(\u_csr.shreg[0] ),
    .B(\u_csr.bit_cnt[3] ),
    .C(_0567_),
    .D(_0590_),
    .Y(_0375_));
 sky130_fd_sc_hd__xnor2_1 _1224_ (.A(\u_csr.u_clr.tog ),
    .B(_0375_),
    .Y(_0229_));
 sky130_fd_sc_hd__nand2_1 _1225_ (.A(\u_csr.bit_cnt[3] ),
    .B(_0590_),
    .Y(_0376_));
 sky130_fd_sc_hd__xnor2_1 _1226_ (.A(\u_csr.u_commit.tog ),
    .B(_0376_),
    .Y(_0230_));
 sky130_fd_sc_hd__mux2_2 _1227_ (.A0(\u_csr.shreg[6] ),
    .A1(\u_csr.r_odiv[7] ),
    .S(_0593_),
    .X(_0231_));
 sky130_fd_sc_hd__mux2_2 _1228_ (.A0(\u_csr.shreg[6] ),
    .A1(\u_csr.r_mdiv[7] ),
    .S(_0595_),
    .X(_0232_));
 sky130_fd_sc_hd__mux2_2 _1229_ (.A0(\u_csr.shreg[6] ),
    .A1(\u_csr.r_ens[7] ),
    .S(_0596_),
    .X(_0233_));
 sky130_fd_sc_hd__mux2_2 _1230_ (.A0(\u_csr.shreg[6] ),
    .A1(\u_csr.r_ctrl[7] ),
    .S(_0597_),
    .X(_0234_));
 sky130_fd_sc_hd__a21oi_1 _1231_ (.A1(_0665_),
    .A2(_0661_),
    .B1(\u_lock.u_lk.d[0] ),
    .Y(_0377_));
 sky130_fd_sc_hd__or2_0 _1232_ (.A(_0643_),
    .B(_0377_),
    .X(_0378_));
 sky130_fd_sc_hd__o21ai_0 _1233_ (.A1(_0460_),
    .A2(_0362_),
    .B1(\u_lock.u_lk.d[0] ),
    .Y(_0379_));
 sky130_fd_sc_hd__a21oi_1 _1234_ (.A1(_0378_),
    .A2(_0379_),
    .B1(_0645_),
    .Y(_0235_));
 sky130_fd_sc_hd__mux2_2 _1235_ (.A0(\u_csr.r_seqdly[7] ),
    .A1(\c_seqdly[7] ),
    .S(_0598_),
    .X(_0236_));
 sky130_fd_sc_hd__mux2_2 _1236_ (.A0(\u_csr.r_test[7] ),
    .A1(\u_csr.shreg[6] ),
    .S(_0600_),
    .X(_0237_));
 sky130_fd_sc_hd__mux2_2 _1237_ (.A0(\u_csr.r_lockw[7] ),
    .A1(\c_lockw[7] ),
    .S(net55),
    .X(_0238_));
 sky130_fd_sc_hd__mux2_2 _1238_ (.A0(\u_csr.r_vcobnd[7] ),
    .A1(net41),
    .S(net55),
    .X(_0239_));
 sky130_fd_sc_hd__mux2_2 _1240_ (.A0(\u_csr.r_cpiset[7] ),
    .A1(net16),
    .S(net55),
    .X(_0240_));
 sky130_fd_sc_hd__mux2_2 _1241_ (.A0(\u_csr.r_seqdly[7] ),
    .A1(\u_csr.shreg[6] ),
    .S(_0606_),
    .X(_0241_));
 sky130_fd_sc_hd__mux2_2 _1242_ (.A0(\u_csr.r_odiv[2] ),
    .A1(\c_outdiv[2] ),
    .S(net55),
    .X(_0242_));
 sky130_fd_sc_hd__mux2_2 _1243_ (.A0(\u_csr.r_mdiv[7] ),
    .A1(net29),
    .S(net55),
    .X(_0243_));
 sky130_fd_sc_hd__mux2_2 _1244_ (.A0(\u_csr.r_ens[2] ),
    .A1(c_en_cp_man),
    .S(net55),
    .X(_0244_));
 sky130_fd_sc_hd__mux2_2 _1245_ (.A0(\u_csr.shreg[6] ),
    .A1(\u_csr.r_lockw[7] ),
    .S(_0609_),
    .X(_0245_));
 sky130_fd_sc_hd__mux2_2 _1246_ (.A0(\u_csr.r_ens[1] ),
    .A1(c_en_vco_man),
    .S(net55),
    .X(_0246_));
 sky130_fd_sc_hd__nand2_1 _1247_ (.A(\u_lock.u_en.q[0] ),
    .B(\u_lock.good_cnt[7] ),
    .Y(_0381_));
 sky130_fd_sc_hd__nor3_1 _1248_ (.A(_0645_),
    .B(\u_lock.good_cnt[7] ),
    .C(_0460_),
    .Y(_0382_));
 sky130_fd_sc_hd__nand4_1 _1249_ (.A(\u_lock.good_cnt[6] ),
    .B(\u_lock.good_cnt[5] ),
    .C(_0671_),
    .D(_0382_),
    .Y(_0383_));
 sky130_fd_sc_hd__a311o_1 _1250_ (.A1(\u_lock.good_cnt[6] ),
    .A2(\u_lock.good_cnt[5] ),
    .A3(_0671_),
    .B1(_0381_),
    .C1(_0643_),
    .X(_0384_));
 sky130_fd_sc_hd__o221ai_1 _1251_ (.A1(_0665_),
    .A2(_0381_),
    .B1(_0383_),
    .B2(_0643_),
    .C1(_0384_),
    .Y(_0248_));
 sky130_fd_sc_hd__mux2_2 _1252_ (.A0(\u_csr.r_ens[0] ),
    .A1(c_en_vreg_man),
    .S(net55),
    .X(_0249_));
 sky130_fd_sc_hd__mux2_2 _1254_ (.A0(\u_csr.r_ctrl[5] ),
    .A1(c_manual_seq),
    .S(net55),
    .X(_0250_));
 sky130_fd_sc_hd__mux2_2 _1255_ (.A0(\u_csr.shreg[6] ),
    .A1(\u_csr.r_vcobnd[7] ),
    .S(_0312_),
    .X(_0251_));
 sky130_fd_sc_hd__mux2_2 _1256_ (.A0(\u_csr.r_ctrl[4] ),
    .A1(c_auto_relock),
    .S(net55),
    .X(_0252_));
 sky130_fd_sc_hd__mux2_2 _1257_ (.A0(\u_csr.r_ctrl[3] ),
    .A1(c_soft_rst),
    .S(net55),
    .X(_0253_));
 sky130_fd_sc_hd__mux2_2 _1258_ (.A0(\u_csr.r_ctrl[2] ),
    .A1(c_bypass_sel),
    .S(net55),
    .X(_0254_));
 sky130_fd_sc_hd__mux2_2 _1259_ (.A0(\u_csr.shreg[6] ),
    .A1(\u_csr.r_cpiset[7] ),
    .S(_0313_),
    .X(_0255_));
 sky130_fd_sc_hd__mux2_2 _1260_ (.A0(\u_csr.r_ctrl[1] ),
    .A1(c_clkout_en),
    .S(net55),
    .X(_0256_));
 sky130_fd_sc_hd__mux2_2 _1261_ (.A0(\u_csr.r_ctrl[0] ),
    .A1(c_pll_en),
    .S(net55),
    .X(_0258_));
 sky130_fd_sc_hd__inv_1 _1262_ (.A(net17),
    .Y(_0386_));
 sky130_fd_sc_hd__o21ai_0 _1263_ (.A1(\u_seq.state[1] ),
    .A2(_0336_),
    .B1(_0320_),
    .Y(_0387_));
 sky130_fd_sc_hd__mux2i_1 _1264_ (.A0(\u_seq.state[1] ),
    .A1(c_pll_en),
    .S(c_manual_seq),
    .Y(_0388_));
 sky130_fd_sc_hd__nor3_1 _1265_ (.A(c_soft_rst),
    .B(_0388_),
    .C(_0387_),
    .Y(_0389_));
 sky130_fd_sc_hd__a21oi_1 _1266_ (.A1(_0386_),
    .A2(_0387_),
    .B1(_0389_),
    .Y(_0259_));
 sky130_fd_sc_hd__inv_1 _1267_ (.A(\u_seq.state[0] ),
    .Y(_0390_));
 sky130_fd_sc_hd__a21oi_1 _1268_ (.A1(_0390_),
    .A2(net18),
    .B1(\u_seq.state[5] ),
    .Y(_0391_));
 sky130_fd_sc_hd__nor2_1 _1269_ (.A(c_manual_seq),
    .B(_0391_),
    .Y(_0392_));
 sky130_fd_sc_hd__a21oi_1 _1270_ (.A1(c_manual_seq),
    .A2(c_en_cp_man),
    .B1(_0392_),
    .Y(_0393_));
 sky130_fd_sc_hd__nor2_1 _1271_ (.A(c_soft_rst),
    .B(_0393_),
    .Y(_0260_));
 sky130_fd_sc_hd__nand3_1 _1272_ (.A(\u_seq.dwell[5] ),
    .B(\u_seq.dwell[6] ),
    .C(_0344_),
    .Y(_0394_));
 sky130_fd_sc_hd__xor2_1 _1273_ (.A(\u_seq.dwell[7] ),
    .B(_0394_),
    .X(_0395_));
 sky130_fd_sc_hd__a21oi_1 _1274_ (.A1(_0321_),
    .A2(_0332_),
    .B1(_0395_),
    .Y(_0261_));
 sky130_fd_sc_hd__a21oi_1 _1275_ (.A1(_0390_),
    .A2(net19),
    .B1(\u_seq.state[2] ),
    .Y(_0396_));
 sky130_fd_sc_hd__nor2_1 _1276_ (.A(c_manual_seq),
    .B(_0396_),
    .Y(_0397_));
 sky130_fd_sc_hd__a21oi_1 _1277_ (.A1(c_manual_seq),
    .A2(c_en_vco_man),
    .B1(_0397_),
    .Y(_0398_));
 sky130_fd_sc_hd__nor2_1 _1278_ (.A(c_soft_rst),
    .B(_0398_),
    .Y(_0262_));
 sky130_fd_sc_hd__a21oi_1 _1279_ (.A1(_0390_),
    .A2(net20),
    .B1(\u_seq.state[3] ),
    .Y(_0399_));
 sky130_fd_sc_hd__nor2_1 _1280_ (.A(c_manual_seq),
    .B(_0399_),
    .Y(_0400_));
 sky130_fd_sc_hd__a21oi_1 _1281_ (.A1(c_manual_seq),
    .A2(c_en_vreg_man),
    .B1(_0400_),
    .Y(_0401_));
 sky130_fd_sc_hd__nor2_1 _1282_ (.A(c_soft_rst),
    .B(_0401_),
    .Y(_0263_));
 sky130_fd_sc_hd__a21oi_1 _1283_ (.A1(_0390_),
    .A2(net30),
    .B1(\u_seq.state[1] ),
    .Y(_0402_));
 sky130_fd_sc_hd__nor2_1 _1284_ (.A(c_manual_seq),
    .B(_0402_),
    .Y(_0403_));
 sky130_fd_sc_hd__a21oi_1 _1285_ (.A1(c_manual_seq),
    .A2(c_pll_en),
    .B1(_0403_),
    .Y(_0404_));
 sky130_fd_sc_hd__nor2_1 _1286_ (.A(c_soft_rst),
    .B(_0404_),
    .Y(_0264_));
 sky130_fd_sc_hd__nand2_1 _1287_ (.A(seq_done),
    .B(_0317_),
    .Y(_0405_));
 sky130_fd_sc_hd__nand2_1 _1288_ (.A(_0320_),
    .B(_0405_),
    .Y(_0265_));
 sky130_fd_sc_hd__and3_1 _1289_ (.A(\u_lock.u_en.q[0] ),
    .B(\u_lock.bad_cnt[7] ),
    .C(_0365_),
    .X(_0266_));
 sky130_fd_sc_hd__o21ai_0 _1290_ (.A1(c_pll_en),
    .A2(_0335_),
    .B1(_0319_),
    .Y(_0090_));
 sky130_fd_sc_hd__o21ai_0 _1291_ (.A1(_0322_),
    .A2(_0326_),
    .B1(_0327_),
    .Y(_0406_));
 sky130_fd_sc_hd__nand2b_1 _1292_ (.A_N(_0045_),
    .B(_0329_),
    .Y(_0407_));
 sky130_fd_sc_hd__nand3_1 _1293_ (.A(\u_seq.state[5] ),
    .B(_0406_),
    .C(_0407_),
    .Y(_0408_));
 sky130_fd_sc_hd__o21ai_0 _1294_ (.A1(_0328_),
    .A2(_0330_),
    .B1(\u_seq.state[1] ),
    .Y(_0409_));
 sky130_fd_sc_hd__a21oi_1 _1295_ (.A1(_0408_),
    .A2(_0409_),
    .B1(_0315_),
    .Y(_0091_));
 sky130_fd_sc_hd__nand3_1 _1296_ (.A(\u_seq.state[3] ),
    .B(_0406_),
    .C(_0407_),
    .Y(_0410_));
 sky130_fd_sc_hd__o21ai_0 _1297_ (.A1(_0328_),
    .A2(_0330_),
    .B1(\u_seq.state[2] ),
    .Y(_0411_));
 sky130_fd_sc_hd__a21oi_1 _1298_ (.A1(_0410_),
    .A2(_0411_),
    .B1(_0315_),
    .Y(_0092_));
 sky130_fd_sc_hd__o21ai_0 _1299_ (.A1(_0328_),
    .A2(_0330_),
    .B1(\u_seq.state[3] ),
    .Y(_0412_));
 sky130_fd_sc_hd__nand2_1 _1300_ (.A(c_pll_en),
    .B(\u_seq.state[0] ),
    .Y(_0413_));
 sky130_fd_sc_hd__a21oi_1 _1301_ (.A1(_0412_),
    .A2(_0413_),
    .B1(_0315_),
    .Y(_0093_));
 sky130_fd_sc_hd__nand3_1 _1302_ (.A(\u_seq.state[1] ),
    .B(_0406_),
    .C(_0407_),
    .Y(_0414_));
 sky130_fd_sc_hd__nand2_1 _1303_ (.A(c_auto_relock),
    .B(\u_lock.u_ll.q[0] ),
    .Y(_0415_));
 sky130_fd_sc_hd__nand3_1 _1304_ (.A(c_pll_en),
    .B(\u_seq.state[4] ),
    .C(_0415_),
    .Y(_0416_));
 sky130_fd_sc_hd__a21oi_1 _1305_ (.A1(_0414_),
    .A2(_0416_),
    .B1(_0315_),
    .Y(_0094_));
 sky130_fd_sc_hd__nand4_1 _1306_ (.A(c_pll_en),
    .B(\u_seq.state[4] ),
    .C(c_auto_relock),
    .D(\u_lock.u_ll.q[0] ),
    .Y(_0417_));
 sky130_fd_sc_hd__o21ai_0 _1307_ (.A1(_0328_),
    .A2(_0330_),
    .B1(\u_seq.state[5] ),
    .Y(_0418_));
 sky130_fd_sc_hd__nand3_1 _1308_ (.A(\u_seq.state[2] ),
    .B(_0406_),
    .C(_0407_),
    .Y(_0419_));
 sky130_fd_sc_hd__a31oi_1 _1309_ (.A1(_0417_),
    .A2(_0418_),
    .A3(_0419_),
    .B1(_0315_),
    .Y(_0095_));
 sky130_fd_sc_hd__xnor2_1 _1310_ (.A(\u_clkout.cnt[2] ),
    .B(_0088_),
    .Y(_0420_));
 sky130_fd_sc_hd__nor2_1 _1311_ (.A(_0451_),
    .B(_0420_),
    .Y(_0269_));
 sky130_fd_sc_hd__inv_1 _1312__64 (.A(clknet_1_1__leaf_pll_d2),
    .Y(net63));
 sky130_fd_sc_hd__inv_1 _1312__65 (.A(clknet_1_1__leaf_pll_d2),
    .Y(net64));
 sky130_fd_sc_hd__a21oi_1 _1313_ (.A1(_0031_),
    .A2(_0038_),
    .B1(_0043_),
    .Y(_0421_));
 sky130_fd_sc_hd__o21ai_0 _1314_ (.A1(\u_clkout.N[2] ),
    .A2(_0421_),
    .B1(\u_clkout.divq ),
    .Y(_0422_));
 sky130_fd_sc_hd__o31ai_1 _1315_ (.A1(\u_clkout.N[2] ),
    .A2(net64),
    .A3(_0421_),
    .B1(_0422_),
    .Y(_0423_));
 sky130_fd_sc_hd__mux2_2 _1316_ (.A0(_0423_),
    .A1(clknet_1_0__leaf_refclk_i),
    .S(c_bypass_sel),
    .X(\u_clkout.sel_clk ));
 sky130_fd_sc_hd__and2_1 _1317_ (.A(\u_clkout.u_gate.en_lat ),
    .B(\clknet_1_0__leaf_u_clkout.sel_clk ),
    .X(net8));
 sky130_fd_sc_hd__or2_2 _1318_ (.A(c_clkout_en),
    .B(net7),
    .X(_0270_));
 sky130_fd_sc_hd__mux2_2 _1319_ (.A0(\u_csr.shreg[5] ),
    .A1(\u_csr.addr_r[6] ),
    .S(_0440_),
    .X(_0247_));
 sky130_fd_sc_hd__mux4_2 _1320_ (.A0(\u_csr.r_ctrl[7] ),
    .A1(\u_csr.r_ens[7] ),
    .A2(\u_csr.r_mdiv[7] ),
    .A3(\u_csr.r_odiv[7] ),
    .S0(net58),
    .S1(net57),
    .X(_0424_));
 sky130_fd_sc_hd__mux4_2 _1321_ (.A0(\u_csr.r_cpiset[7] ),
    .A1(\u_csr.r_vcobnd[7] ),
    .A2(\u_csr.r_lockw[7] ),
    .A3(\u_csr.r_seqdly[7] ),
    .S0(net58),
    .S1(net57),
    .X(_0425_));
 sky130_fd_sc_hd__a22oi_1 _1322_ (.A1(_0548_),
    .A2(_0424_),
    .B1(_0425_),
    .B2(_0552_),
    .Y(_0426_));
 sky130_fd_sc_hd__nand2_1 _1323_ (.A(\u_csr.r_test[7] ),
    .B(_0546_),
    .Y(_0427_));
 sky130_fd_sc_hd__nand3_1 _1324_ (.A(_0537_),
    .B(_0426_),
    .C(_0427_),
    .Y(_0428_));
 sky130_fd_sc_hd__a22o_1 _1325_ (.A1(\u_csr.sh_out[6] ),
    .A2(_0541_),
    .B1(_0542_),
    .B2(_0428_),
    .X(_0278_));
 sky130_fd_sc_hd__nor2b_1 _1326_ (.A(\u_lock.div_d ),
    .B_N(\u_lock.u_div.q[0] ),
    .Y(\u_lock.div_edge ));
 sky130_fd_sc_hd__nand3_1 _1327_ (.A(\u_lock.div_cnt[14] ),
    .B(\u_lock.div_cnt[13] ),
    .C(_0479_),
    .Y(_0429_));
 sky130_fd_sc_hd__xor2_1 _1328_ (.A(\u_lock.div_cnt[15] ),
    .B(_0429_),
    .X(_0430_));
 sky130_fd_sc_hd__nor2_1 _1329_ (.A(net54),
    .B(_0430_),
    .Y(_0285_));
 sky130_fd_sc_hd__nand2_1 _1330_ (.A(\u_lock.win_cnt[14] ),
    .B(_0513_),
    .Y(_0431_));
 sky130_fd_sc_hd__o21ai_0 _1331_ (.A1(_0510_),
    .A2(_0431_),
    .B1(\u_lock.win_cnt[15] ),
    .Y(_0432_));
 sky130_fd_sc_hd__or3_1 _1332_ (.A(\u_lock.win_cnt[15] ),
    .B(_0510_),
    .C(_0431_),
    .X(_0433_));
 sky130_fd_sc_hd__a21oi_1 _1333_ (.A1(_0432_),
    .A2(_0433_),
    .B1(_0461_),
    .Y(_0301_));
 sky130_fd_sc_hd__inv_1 _1334_ (.A(\u_lock.bad_cnt[1] ),
    .Y(_0051_));
 sky130_fd_sc_hd__and2_1 _1335_ (.A(net30),
    .B(seq_done),
    .X(\u_lock.u_en.d[0] ));
 sky130_fd_sc_hd__and2_1 _1336_ (.A(clknet_1_1__leaf_refclk_i),
    .B(\u_refgate.en_lat ),
    .X(net31));
 sky130_fd_sc_hd__or2_2 _1337_ (.A(net30),
    .B(net7),
    .X(_0311_));
 sky130_fd_sc_hd__inv_1 _1338_ (.A(_0037_),
    .Y(_0434_));
 sky130_fd_sc_hd__a211oi_1 _1339_ (.A1(_0016_),
    .A2(_0434_),
    .B1(_0015_),
    .C1(\u_clkout.cnt[2] ),
    .Y(_0096_));
 sky130_fd_sc_hd__ha_1 _1340_ (.A(\u_lock.good_cnt[3] ),
    .B(_0003_),
    .COUT(_0004_),
    .SUM(_0005_));
 sky130_fd_sc_hd__ha_1 _1341_ (.A(_0006_),
    .B(\u_lock.k_s[0] ),
    .COUT(_0007_),
    .SUM(_0008_));
 sky130_fd_sc_hd__ha_1 _1342_ (.A(_0009_),
    .B(_0010_),
    .COUT(_0011_),
    .SUM(_0693_));
 sky130_fd_sc_hd__ha_1 _1343_ (.A(\u_csr.bit_cnt[0] ),
    .B(\u_csr.bit_cnt[1] ),
    .COUT(_0012_),
    .SUM(_0694_));
 sky130_fd_sc_hd__ha_1 _1344_ (.A(\u_csr.bit_cnt[0] ),
    .B(\u_csr.bit_cnt[1] ),
    .COUT(_0013_),
    .SUM(_0695_));
 sky130_fd_sc_hd__ha_1 _1345_ (.A(\u_clkout.cnt[1] ),
    .B(_0014_),
    .COUT(_0015_),
    .SUM(_0016_));
 sky130_fd_sc_hd__ha_1 _1346_ (.A(\u_lock.win_cnt[0] ),
    .B(\u_lock.win_cnt[1] ),
    .COUT(_0017_),
    .SUM(_0018_));
 sky130_fd_sc_hd__ha_1 _1347_ (.A(\u_lock.win_cnt[0] ),
    .B(\u_lock.win_cnt[1] ),
    .COUT(_0019_),
    .SUM(_0696_));
 sky130_fd_sc_hd__ha_1 _1348_ (.A(\u_lock.div_cnt[1] ),
    .B(_0020_),
    .COUT(_0021_),
    .SUM(\u_lock.div_total[1] ));
 sky130_fd_sc_hd__ha_1 _1349_ (.A(\u_lock.good_cnt[0] ),
    .B(\u_lock.good_cnt[1] ),
    .COUT(_0022_),
    .SUM(_0023_));
 sky130_fd_sc_hd__ha_1 _1350_ (.A(\u_seq.dwell[0] ),
    .B(\u_seq.dwell[1] ),
    .COUT(_0024_),
    .SUM(_0025_));
 sky130_fd_sc_hd__ha_1 _1351_ (.A(_0026_),
    .B(\u_seq.dwell[0] ),
    .COUT(_0697_),
    .SUM(_0027_));
 sky130_fd_sc_hd__ha_1 _1352_ (.A(\c_seqdly[0] ),
    .B(_0028_),
    .COUT(_0029_),
    .SUM(_0698_));
 sky130_fd_sc_hd__ha_1 _1353_ (.A(_0030_),
    .B(_0031_),
    .COUT(_0032_),
    .SUM(_0033_));
 sky130_fd_sc_hd__ha_1 _1354_ (.A(_0034_),
    .B(\u_seq.dwell[5] ),
    .COUT(_0035_),
    .SUM(_0036_));
 sky130_fd_sc_hd__ha_1 _1355_ (.A(_0030_),
    .B(\u_clkout.N[1] ),
    .COUT(_0037_),
    .SUM(_0692_));
 sky130_fd_sc_hd__ha_1 _1356_ (.A(_0039_),
    .B(\u_seq.dwell[3] ),
    .COUT(_0040_),
    .SUM(_0041_));
 sky130_fd_sc_hd__ha_1 _1357_ (.A(_0031_),
    .B(_0038_),
    .COUT(_0042_),
    .SUM(_0699_));
 sky130_fd_sc_hd__ha_1 _1358_ (.A(\u_clkout.N[0] ),
    .B(_0038_),
    .COUT(_0043_),
    .SUM(_0700_));
 sky130_fd_sc_hd__ha_1 _1359_ (.A(_0044_),
    .B(\u_seq.dwell[7] ),
    .COUT(_0045_),
    .SUM(_0046_));
 sky130_fd_sc_hd__ha_1 _1360_ (.A(_0047_),
    .B(\u_clkout.cnt[2] ),
    .COUT(_0048_),
    .SUM(_0049_));
 sky130_fd_sc_hd__ha_1 _1361_ (.A(_0050_),
    .B(_0051_),
    .COUT(_0052_),
    .SUM(_0053_));
 sky130_fd_sc_hd__ha_1 _1362_ (.A(\u_lock.bad_cnt[0] ),
    .B(_0051_),
    .COUT(_0054_),
    .SUM(_0701_));
 sky130_fd_sc_hd__ha_1 _1363_ (.A(\u_lock.bad_cnt[0] ),
    .B(\u_lock.bad_cnt[1] ),
    .COUT(_0055_),
    .SUM(_0702_));
 sky130_fd_sc_hd__ha_1 _1364_ (.A(\u_lock.good_cnt[7] ),
    .B(_0056_),
    .COUT(_0057_),
    .SUM(_0058_));
 sky130_fd_sc_hd__ha_1 _1365_ (.A(_0059_),
    .B(\u_seq.dwell[2] ),
    .COUT(_0060_),
    .SUM(_0061_));
 sky130_fd_sc_hd__ha_1 _1366_ (.A(_0062_),
    .B(\u_seq.dwell[1] ),
    .COUT(_0063_),
    .SUM(_0064_));
 sky130_fd_sc_hd__ha_1 _1367_ (.A(\u_lock.good_cnt[6] ),
    .B(_0065_),
    .COUT(_0066_),
    .SUM(_0067_));
 sky130_fd_sc_hd__ha_1 _1368_ (.A(\u_lock.good_cnt[5] ),
    .B(_0068_),
    .COUT(_0069_),
    .SUM(_0070_));
 sky130_fd_sc_hd__ha_1 _1369_ (.A(\u_lock.good_cnt[2] ),
    .B(_0071_),
    .COUT(_0072_),
    .SUM(_0073_));
 sky130_fd_sc_hd__ha_1 _1370_ (.A(\u_lock.good_cnt[4] ),
    .B(_0074_),
    .COUT(_0075_),
    .SUM(_0076_));
 sky130_fd_sc_hd__ha_1 _1371_ (.A(_0077_),
    .B(\u_seq.dwell[4] ),
    .COUT(_0078_),
    .SUM(_0079_));
 sky130_fd_sc_hd__ha_1 _1372_ (.A(_0699_),
    .B(\u_clkout.cnt[1] ),
    .COUT(_0080_),
    .SUM(_0081_));
 sky130_fd_sc_hd__ha_1 _1373_ (.A(_0082_),
    .B(\u_seq.dwell[6] ),
    .COUT(_0083_),
    .SUM(_0084_));
 sky130_fd_sc_hd__ha_1 _1374_ (.A(\u_lock.good_cnt[1] ),
    .B(_0085_),
    .COUT(_0086_),
    .SUM(_0087_));
 sky130_fd_sc_hd__ha_1 _1375_ (.A(\u_lock.div_cnt[0] ),
    .B(\u_lock.div_edge ),
    .COUT(_0020_),
    .SUM(\u_lock.div_total[0] ));
 sky130_fd_sc_hd__ha_1 _1376_ (.A(\u_clkout.cnt[0] ),
    .B(\u_clkout.cnt[1] ),
    .COUT(_0088_),
    .SUM(_0089_));
 sky130_fd_sc_hd__clkbuf_16 clkbuf_0_pll_clk_i (.A(pll_clk_i),
    .X(clknet_0_pll_clk_i));
 sky130_fd_sc_hd__clkbuf_16 clkbuf_0_pll_clk_i_regs (.A(pll_clk_i_regs),
    .X(clknet_0_pll_clk_i_regs));
 sky130_fd_sc_hd__clkbuf_16 clkbuf_0_pll_d2 (.A(pll_d2),
    .X(clknet_0_pll_d2));
 sky130_fd_sc_hd__clkbuf_16 clkbuf_0_refclk_i (.A(refclk_i),
    .X(clknet_0_refclk_i));
 sky130_fd_sc_hd__clkbuf_16 clkbuf_0_refclk_i_regs (.A(refclk_i_regs),
    .X(clknet_0_refclk_i_regs));
 sky130_fd_sc_hd__clkbuf_16 clkbuf_0_spi_sclk_i (.A(spi_sclk_i),
    .X(clknet_0_spi_sclk_i));
 sky130_fd_sc_hd__clkbuf_16 \clkbuf_0_u_clkout.sel_clk  (.A(\u_clkout.sel_clk ),
    .X(\clknet_0_u_clkout.sel_clk ));
 sky130_fd_sc_hd__clkbuf_16 \clkbuf_0_u_clkout.sel_clk_regs  (.A(\u_clkout.sel_clk_regs ),
    .X(\clknet_0_u_clkout.sel_clk_regs ));
 sky130_fd_sc_hd__clkbuf_16 clkbuf_1_0__f_pll_clk_i (.A(clknet_0_pll_clk_i),
    .X(clknet_1_0__leaf_pll_clk_i));
 sky130_fd_sc_hd__clkbuf_16 clkbuf_1_0__f_pll_clk_i_regs (.A(clknet_0_pll_clk_i_regs),
    .X(clknet_1_0__leaf_pll_clk_i_regs));
 sky130_fd_sc_hd__clkbuf_16 clkbuf_1_0__f_pll_d2 (.A(clknet_0_pll_d2),
    .X(clknet_1_0__leaf_pll_d2));
 sky130_fd_sc_hd__clkbuf_16 clkbuf_1_0__f_refclk_i (.A(clknet_0_refclk_i),
    .X(clknet_1_0__leaf_refclk_i));
 sky130_fd_sc_hd__clkbuf_16 \clkbuf_1_0__f_u_clkout.sel_clk  (.A(\clknet_0_u_clkout.sel_clk ),
    .X(\clknet_1_0__leaf_u_clkout.sel_clk ));
 sky130_fd_sc_hd__clkbuf_16 \clkbuf_1_0__f_u_clkout.sel_clk_regs  (.A(\clknet_0_u_clkout.sel_clk_regs ),
    .X(\clknet_1_0__leaf_u_clkout.sel_clk_regs ));
 sky130_fd_sc_hd__clkbuf_16 clkbuf_1_1__f_pll_clk_i_regs (.A(clknet_0_pll_clk_i_regs),
    .X(clknet_1_1__leaf_pll_clk_i_regs));
 sky130_fd_sc_hd__clkbuf_16 clkbuf_1_1__f_pll_d2 (.A(clknet_0_pll_d2),
    .X(clknet_1_1__leaf_pll_d2));
 sky130_fd_sc_hd__clkbuf_16 clkbuf_1_1__f_refclk_i (.A(delaynet_6_refclk),
    .X(clknet_1_1__leaf_refclk_i));
 sky130_fd_sc_hd__clkbuf_16 clkbuf_3_0__f_spi_sclk_i (.A(clknet_0_spi_sclk_i),
    .X(clknet_3_0__leaf_spi_sclk_i));
 sky130_fd_sc_hd__clkbuf_16 clkbuf_3_1__f_spi_sclk_i (.A(clknet_0_spi_sclk_i),
    .X(clknet_3_1__leaf_spi_sclk_i));
 sky130_fd_sc_hd__clkbuf_16 clkbuf_3_2__f_spi_sclk_i (.A(clknet_0_spi_sclk_i),
    .X(clknet_3_2__leaf_spi_sclk_i));
 sky130_fd_sc_hd__clkbuf_16 clkbuf_3_3__f_spi_sclk_i (.A(clknet_0_spi_sclk_i),
    .X(clknet_3_3__leaf_spi_sclk_i));
 sky130_fd_sc_hd__clkbuf_16 clkbuf_3_4__f_spi_sclk_i (.A(clknet_0_spi_sclk_i),
    .X(clknet_3_4__leaf_spi_sclk_i));
 sky130_fd_sc_hd__clkbuf_16 clkbuf_3_5__f_spi_sclk_i (.A(clknet_0_spi_sclk_i),
    .X(clknet_3_5__leaf_spi_sclk_i));
 sky130_fd_sc_hd__clkbuf_16 clkbuf_3_6__f_spi_sclk_i (.A(clknet_0_spi_sclk_i),
    .X(clknet_3_6__leaf_spi_sclk_i));
 sky130_fd_sc_hd__clkbuf_16 clkbuf_3_7__f_spi_sclk_i (.A(clknet_0_spi_sclk_i),
    .X(clknet_3_7__leaf_spi_sclk_i));
 sky130_fd_sc_hd__clkbuf_16 clkbuf_4_0_0_refclk_i_regs (.A(clknet_0_refclk_i_regs),
    .X(clknet_4_0_0_refclk_i_regs));
 sky130_fd_sc_hd__clkbuf_16 clkbuf_4_10_0_refclk_i_regs (.A(clknet_0_refclk_i_regs),
    .X(clknet_4_10_0_refclk_i_regs));
 sky130_fd_sc_hd__clkbuf_16 clkbuf_4_11_0_refclk_i_regs (.A(clknet_0_refclk_i_regs),
    .X(clknet_4_11_0_refclk_i_regs));
 sky130_fd_sc_hd__clkbuf_16 clkbuf_4_12_0_refclk_i_regs (.A(clknet_0_refclk_i_regs),
    .X(clknet_4_12_0_refclk_i_regs));
 sky130_fd_sc_hd__clkbuf_16 clkbuf_4_13_0_refclk_i_regs (.A(clknet_0_refclk_i_regs),
    .X(clknet_4_13_0_refclk_i_regs));
 sky130_fd_sc_hd__clkbuf_16 clkbuf_4_14_0_refclk_i_regs (.A(clknet_0_refclk_i_regs),
    .X(clknet_4_14_0_refclk_i_regs));
 sky130_fd_sc_hd__clkbuf_16 clkbuf_4_15_0_refclk_i_regs (.A(clknet_0_refclk_i_regs),
    .X(clknet_4_15_0_refclk_i_regs));
 sky130_fd_sc_hd__clkbuf_16 clkbuf_4_1_0_refclk_i_regs (.A(clknet_0_refclk_i_regs),
    .X(clknet_4_1_0_refclk_i_regs));
 sky130_fd_sc_hd__clkbuf_16 clkbuf_4_2_0_refclk_i_regs (.A(clknet_0_refclk_i_regs),
    .X(clknet_4_2_0_refclk_i_regs));
 sky130_fd_sc_hd__clkbuf_16 clkbuf_4_3_0_refclk_i_regs (.A(clknet_0_refclk_i_regs),
    .X(clknet_4_3_0_refclk_i_regs));
 sky130_fd_sc_hd__clkbuf_16 clkbuf_4_4_0_refclk_i_regs (.A(clknet_0_refclk_i_regs),
    .X(clknet_4_4_0_refclk_i_regs));
 sky130_fd_sc_hd__clkbuf_16 clkbuf_4_5_0_refclk_i_regs (.A(clknet_0_refclk_i_regs),
    .X(clknet_4_5_0_refclk_i_regs));
 sky130_fd_sc_hd__clkbuf_16 clkbuf_4_6_0_refclk_i_regs (.A(clknet_0_refclk_i_regs),
    .X(clknet_4_6_0_refclk_i_regs));
 sky130_fd_sc_hd__clkbuf_16 clkbuf_4_7_0_refclk_i_regs (.A(clknet_0_refclk_i_regs),
    .X(clknet_4_7_0_refclk_i_regs));
 sky130_fd_sc_hd__clkbuf_16 clkbuf_4_8_0_refclk_i_regs (.A(clknet_0_refclk_i_regs),
    .X(clknet_4_8_0_refclk_i_regs));
 sky130_fd_sc_hd__clkbuf_16 clkbuf_4_9_0_refclk_i_regs (.A(clknet_0_refclk_i_regs),
    .X(clknet_4_9_0_refclk_i_regs));
 sky130_fd_sc_hd__clkbuf_16 clkbuf_regs_0_pll_clk (.A(pll_clk_i),
    .X(pll_clk_i_regs));
 sky130_fd_sc_hd__clkbuf_16 clkbuf_regs_1_refclk (.A(delaynet_7_refclk),
    .X(refclk_i_regs));
 sky130_fd_sc_hd__clkbuf_16 clkbuf_regs_2_refclk (.A(\u_clkout.sel_clk ),
    .X(\u_clkout.sel_clk_regs ));
 sky130_fd_sc_hd__clkbuf_1 clkload0 (.A(clknet_1_1__leaf_pll_clk_i_regs));
 sky130_fd_sc_hd__clkbuf_1 clkload1 (.A(clknet_1_1__leaf_refclk_i));
 sky130_fd_sc_hd__inv_8 clkload10 (.A(clknet_4_9_0_refclk_i_regs));
 sky130_fd_sc_hd__inv_8 clkload11 (.A(clknet_4_10_0_refclk_i_regs));
 sky130_fd_sc_hd__inv_6 clkload12 (.A(clknet_4_11_0_refclk_i_regs));
 sky130_fd_sc_hd__clkinvlp_4 clkload13 (.A(clknet_4_12_0_refclk_i_regs));
 sky130_fd_sc_hd__inv_6 clkload14 (.A(clknet_4_13_0_refclk_i_regs));
 sky130_fd_sc_hd__inv_8 clkload15 (.A(clknet_4_14_0_refclk_i_regs));
 sky130_fd_sc_hd__inv_6 clkload16 (.A(clknet_4_15_0_refclk_i_regs));
 sky130_fd_sc_hd__inv_6 clkload17 (.A(clknet_3_0__leaf_spi_sclk_i));
 sky130_fd_sc_hd__clkinvlp_4 clkload18 (.A(clknet_3_1__leaf_spi_sclk_i));
 sky130_fd_sc_hd__inv_8 clkload19 (.A(clknet_3_2__leaf_spi_sclk_i));
 sky130_fd_sc_hd__inv_6 clkload2 (.A(clknet_4_0_0_refclk_i_regs));
 sky130_fd_sc_hd__inv_6 clkload20 (.A(clknet_3_3__leaf_spi_sclk_i));
 sky130_fd_sc_hd__clkinvlp_4 clkload21 (.A(clknet_3_4__leaf_spi_sclk_i));
 sky130_fd_sc_hd__clkinv_2 clkload22 (.A(clknet_3_6__leaf_spi_sclk_i));
 sky130_fd_sc_hd__inv_6 clkload23 (.A(clknet_3_7__leaf_spi_sclk_i));
 sky130_fd_sc_hd__bufinv_8 clkload24 (.A(clknet_1_1__leaf_pll_d2));
 sky130_fd_sc_hd__inv_6 clkload3 (.A(clknet_4_1_0_refclk_i_regs));
 sky130_fd_sc_hd__clkinvlp_4 clkload4 (.A(clknet_4_3_0_refclk_i_regs));
 sky130_fd_sc_hd__clkinv_4 clkload5 (.A(clknet_4_4_0_refclk_i_regs));
 sky130_fd_sc_hd__clkinv_4 clkload6 (.A(clknet_4_5_0_refclk_i_regs));
 sky130_fd_sc_hd__inv_6 clkload7 (.A(clknet_4_6_0_refclk_i_regs));
 sky130_fd_sc_hd__bufinv_16 clkload8 (.A(clknet_4_7_0_refclk_i_regs));
 sky130_fd_sc_hd__clkinv_8 clkload9 (.A(clknet_4_8_0_refclk_i_regs));
 sky130_fd_sc_hd__dfrtp_1 \cs_core[0]$_DFF_PN0_  (.D(net),
    .Q(\cs_core[0] ),
    .RESET_B(net2),
    .CLK(clknet_4_0_0_refclk_i_regs));
 sky130_fd_sc_hd__conb_1 \cs_core[0]$_DFF_PN0__1  (.HI(net));
 sky130_fd_sc_hd__dfrtp_4 \cs_core[1]$_DFF_PN0_  (.D(\cs_core[0] ),
    .Q(core_rst_n),
    .RESET_B(net2),
    .CLK(clknet_4_0_0_refclk_i_regs));
 sky130_fd_sc_hd__dfrtp_1 \cs_pll[0]$_DFF_PN0_  (.D(net1),
    .Q(\cs_pll[0] ),
    .RESET_B(net2),
    .CLK(clknet_1_0__leaf_pll_clk_i_regs));
 sky130_fd_sc_hd__conb_1 \cs_pll[0]$_DFF_PN0__2  (.HI(net1));
 sky130_fd_sc_hd__dfrtp_1 \cs_pll[1]$_DFF_PN0_  (.D(\cs_pll[0] ),
    .Q(\cs_pll[1] ),
    .RESET_B(net2),
    .CLK(clknet_1_1__leaf_pll_clk_i_regs));
 sky130_fd_sc_hd__clkbuf_16 delaybuf_0_refclk (.A(clknet_0_refclk_i),
    .X(delaynet_0_refclk));
 sky130_fd_sc_hd__clkbuf_16 delaybuf_1_refclk (.A(delaynet_0_refclk),
    .X(delaynet_1_refclk));
 sky130_fd_sc_hd__clkbuf_16 delaybuf_2_refclk (.A(delaynet_1_refclk),
    .X(delaynet_2_refclk));
 sky130_fd_sc_hd__clkbuf_16 delaybuf_3_refclk (.A(delaynet_2_refclk),
    .X(delaynet_3_refclk));
 sky130_fd_sc_hd__clkbuf_16 delaybuf_4_refclk (.A(delaynet_3_refclk),
    .X(delaynet_4_refclk));
 sky130_fd_sc_hd__clkbuf_16 delaybuf_5_refclk (.A(delaynet_4_refclk),
    .X(delaynet_5_refclk));
 sky130_fd_sc_hd__clkbuf_16 delaybuf_6_refclk (.A(delaynet_5_refclk),
    .X(delaynet_6_refclk));
 sky130_fd_sc_hd__clkbuf_16 delaybuf_7_refclk (.A(refclk_i),
    .X(delaynet_7_refclk));
 sky130_fd_sc_hd__clkdlybuf4s50_1 input3 (.A(rst_n_i),
    .X(net2));
 sky130_fd_sc_hd__clkdlybuf4s50_1 input4 (.A(scan_en_i),
    .X(net3));
 sky130_fd_sc_hd__clkdlybuf4s50_1 input5 (.A(scan_in_i),
    .X(net4));
 sky130_fd_sc_hd__clkdlybuf4s50_1 input6 (.A(spi_cs_n_i),
    .X(net5));
 sky130_fd_sc_hd__clkdlybuf4s50_1 input7 (.A(spi_sdi_i),
    .X(net6));
 sky130_fd_sc_hd__clkdlybuf4s50_1 input8 (.A(test_mode_i),
    .X(net7));
 sky130_fd_sc_hd__clkdlybuf4s50_1 output10 (.A(net9),
    .X(cp_iset_o[0]));
 sky130_fd_sc_hd__clkdlybuf4s50_1 output11 (.A(net10),
    .X(cp_iset_o[1]));
 sky130_fd_sc_hd__clkdlybuf4s50_1 output12 (.A(net11),
    .X(cp_iset_o[2]));
 sky130_fd_sc_hd__clkdlybuf4s50_1 output13 (.A(net12),
    .X(cp_iset_o[3]));
 sky130_fd_sc_hd__clkdlybuf4s50_1 output14 (.A(net13),
    .X(cp_iset_o[4]));
 sky130_fd_sc_hd__clkdlybuf4s50_1 output15 (.A(net14),
    .X(cp_iset_o[5]));
 sky130_fd_sc_hd__clkdlybuf4s50_1 output16 (.A(net15),
    .X(cp_iset_o[6]));
 sky130_fd_sc_hd__clkdlybuf4s50_1 output17 (.A(net16),
    .X(cp_iset_o[7]));
 sky130_fd_sc_hd__clkdlybuf4s50_1 output18 (.A(net17),
    .X(div_rst_o));
 sky130_fd_sc_hd__clkdlybuf4s50_1 output19 (.A(net18),
    .X(en_cp_o));
 sky130_fd_sc_hd__clkdlybuf4s50_1 output20 (.A(net19),
    .X(en_vco_o));
 sky130_fd_sc_hd__clkdlybuf4s50_1 output21 (.A(net20),
    .X(en_vreg_o));
 sky130_fd_sc_hd__clkdlybuf4s50_1 output22 (.A(net21),
    .X(lock_o));
 sky130_fd_sc_hd__clkdlybuf4s50_1 output23 (.A(net22),
    .X(m_div_o[0]));
 sky130_fd_sc_hd__clkdlybuf4s50_1 output24 (.A(net23),
    .X(m_div_o[1]));
 sky130_fd_sc_hd__clkdlybuf4s50_1 output25 (.A(net24),
    .X(m_div_o[2]));
 sky130_fd_sc_hd__clkdlybuf4s50_1 output26 (.A(net25),
    .X(m_div_o[3]));
 sky130_fd_sc_hd__clkdlybuf4s50_1 output27 (.A(net26),
    .X(m_div_o[4]));
 sky130_fd_sc_hd__clkdlybuf4s50_1 output28 (.A(net27),
    .X(m_div_o[5]));
 sky130_fd_sc_hd__clkdlybuf4s50_1 output29 (.A(net28),
    .X(m_div_o[6]));
 sky130_fd_sc_hd__clkdlybuf4s50_1 output30 (.A(net29),
    .X(m_div_o[7]));
 sky130_fd_sc_hd__clkdlybuf4s50_1 output31 (.A(net30),
    .X(pll_en_o));
 sky130_fd_sc_hd__clkdlybuf4s50_1 output32 (.A(net31),
    .X(ref_o));
 sky130_fd_sc_hd__clkdlybuf4s50_1 output33 (.A(net32),
    .X(scan_out_o));
 sky130_fd_sc_hd__clkdlybuf4s50_1 output34 (.A(net33),
    .X(spi_sdo_o));
 sky130_fd_sc_hd__clkdlybuf4s50_1 output35 (.A(net34),
    .X(vco_band_o[0]));
 sky130_fd_sc_hd__clkdlybuf4s50_1 output36 (.A(net35),
    .X(vco_band_o[1]));
 sky130_fd_sc_hd__clkdlybuf4s50_1 output37 (.A(net36),
    .X(vco_band_o[2]));
 sky130_fd_sc_hd__clkdlybuf4s50_1 output38 (.A(net37),
    .X(vco_band_o[3]));
 sky130_fd_sc_hd__clkdlybuf4s50_1 output39 (.A(net38),
    .X(vco_band_o[4]));
 sky130_fd_sc_hd__clkdlybuf4s50_1 output40 (.A(net39),
    .X(vco_band_o[5]));
 sky130_fd_sc_hd__clkdlybuf4s50_1 output41 (.A(net40),
    .X(vco_band_o[6]));
 sky130_fd_sc_hd__clkdlybuf4s50_1 output42 (.A(net41),
    .X(vco_band_o[7]));
 sky130_fd_sc_hd__clkdlybuf4s50_1 output9 (.A(net8),
    .X(clk_out_o));
 sky130_fd_sc_hd__buf_4 place55 (.A(_0461_),
    .X(net54));
 sky130_fd_sc_hd__buf_4 place56 (.A(_0598_),
    .X(net55));
 sky130_fd_sc_hd__buf_4 place57 (.A(_0097_),
    .X(net56));
 sky130_fd_sc_hd__buf_4 place58 (.A(\u_csr.addr_r[1] ),
    .X(net57));
 sky130_fd_sc_hd__buf_4 place59 (.A(\u_csr.addr_r[0] ),
    .X(net58));
 sky130_fd_sc_hd__buf_4 place60 (.A(net60),
    .X(net59));
 sky130_fd_sc_hd__buf_4 place61 (.A(core_rst_n),
    .X(net60));
 sky130_fd_sc_hd__buf_4 place62 (.A(core_rst_n),
    .X(net61));
 sky130_fd_sc_hd__buf_4 place63 (.A(core_rst_n),
    .X(net62));
 sky130_fd_sc_hd__dfrtp_1 \pll_d2$_DFF_PN0_  (.D(net63),
    .Q(pll_d2),
    .RESET_B(\cs_pll[1] ),
    .CLK(clknet_1_0__leaf_pll_clk_i_regs));
 sky130_fd_sc_hd__dfrtp_1 \scan_ff$_DFFE_PN0P_  (.D(_0228_),
    .Q(net32),
    .RESET_B(net62),
    .CLK(clknet_4_0_0_refclk_i_regs));
 sky130_fd_sc_hd__dfrtp_1 \u_clkout.cnt[0]$_DFF_PN0_  (.D(_0267_),
    .Q(\u_clkout.cnt[0] ),
    .RESET_B(\cs_pll[1] ),
    .CLK(clknet_1_0__leaf_pll_d2));
 sky130_fd_sc_hd__dfrtp_1 \u_clkout.cnt[1]$_DFF_PN0_  (.D(_0268_),
    .Q(\u_clkout.cnt[1] ),
    .RESET_B(\cs_pll[1] ),
    .CLK(clknet_1_0__leaf_pll_d2));
 sky130_fd_sc_hd__dfrtp_1 \u_clkout.cnt[2]$_DFF_PN0_  (.D(_0269_),
    .Q(\u_clkout.cnt[2] ),
    .RESET_B(\cs_pll[1] ),
    .CLK(clknet_1_0__leaf_pll_d2));
 sky130_fd_sc_hd__dfrtp_1 \u_clkout.divq$_DFF_PN0_  (.D(_0096_),
    .Q(\u_clkout.divq ),
    .RESET_B(\cs_pll[1] ),
    .CLK(clknet_1_1__leaf_pll_d2));
 sky130_fd_sc_hd__dlxtn_1 \u_clkout.u_gate.en_lat$_DLATCH_N_  (.D(_0270_),
    .Q(\u_clkout.u_gate.en_lat ),
    .GATE_N(\clknet_1_0__leaf_u_clkout.sel_clk_regs ));
 sky130_fd_sc_hd__dfrtp_1 \u_clkout.u_n.meta[0]$_DFF_PN0_  (.D(\c_outdiv[0] ),
    .Q(\u_clkout.u_n.meta[0] ),
    .RESET_B(\cs_pll[1] ),
    .CLK(clknet_1_1__leaf_pll_d2));
 sky130_fd_sc_hd__dfrtp_1 \u_clkout.u_n.meta[1]$_DFF_PN0_  (.D(\c_outdiv[1] ),
    .Q(\u_clkout.u_n.meta[1] ),
    .RESET_B(\cs_pll[1] ),
    .CLK(clknet_1_0__leaf_pll_d2));
 sky130_fd_sc_hd__dfrtp_1 \u_clkout.u_n.meta[2]$_DFF_PN0_  (.D(\c_outdiv[2] ),
    .Q(\u_clkout.u_n.meta[2] ),
    .RESET_B(\cs_pll[1] ),
    .CLK(clknet_1_0__leaf_pll_d2));
 sky130_fd_sc_hd__dfrtp_1 \u_clkout.u_n.q[0]$_DFF_PN0_  (.D(\u_clkout.u_n.meta[0] ),
    .Q(\u_clkout.N[0] ),
    .RESET_B(\cs_pll[1] ),
    .CLK(clknet_1_1__leaf_pll_d2));
 sky130_fd_sc_hd__dfrtp_1 \u_clkout.u_n.q[1]$_DFF_PN0_  (.D(\u_clkout.u_n.meta[1] ),
    .Q(\u_clkout.N[1] ),
    .RESET_B(\cs_pll[1] ),
    .CLK(clknet_1_0__leaf_pll_d2));
 sky130_fd_sc_hd__dfrtp_1 \u_clkout.u_n.q[2]$_DFF_PN0_  (.D(\u_clkout.u_n.meta[2] ),
    .Q(\u_clkout.N[2] ),
    .RESET_B(\cs_pll[1] ),
    .CLK(clknet_1_0__leaf_pll_d2));
 sky130_fd_sc_hd__dfrtp_1 \u_csr.addr_r[0]$_DFFE_PP0P_  (.D(_0190_),
    .Q(\u_csr.addr_r[0] ),
    .RESET_B(_0098_),
    .CLK(clknet_3_5__leaf_spi_sclk_i));
 sky130_fd_sc_hd__dfrtp_1 \u_csr.addr_r[1]$_DFFE_PP0P_  (.D(_0189_),
    .Q(\u_csr.addr_r[1] ),
    .RESET_B(_0098_),
    .CLK(clknet_3_4__leaf_spi_sclk_i));
 sky130_fd_sc_hd__dfrtp_1 \u_csr.addr_r[2]$_DFFE_PP0P_  (.D(_0188_),
    .Q(\u_csr.addr_r[2] ),
    .RESET_B(_0098_),
    .CLK(clknet_3_4__leaf_spi_sclk_i));
 sky130_fd_sc_hd__dfrtp_1 \u_csr.addr_r[3]$_DFFE_PP0P_  (.D(_0187_),
    .Q(\u_csr.addr_r[3] ),
    .RESET_B(_0098_),
    .CLK(clknet_3_4__leaf_spi_sclk_i));
 sky130_fd_sc_hd__dfrtp_1 \u_csr.addr_r[4]$_DFFE_PP0P_  (.D(_0186_),
    .Q(\u_csr.addr_r[4] ),
    .RESET_B(_0098_),
    .CLK(clknet_3_5__leaf_spi_sclk_i));
 sky130_fd_sc_hd__dfrtp_1 \u_csr.addr_r[5]$_DFFE_PP0P_  (.D(_0185_),
    .Q(\u_csr.addr_r[5] ),
    .RESET_B(_0098_),
    .CLK(clknet_3_5__leaf_spi_sclk_i));
 sky130_fd_sc_hd__dfrtp_1 \u_csr.addr_r[6]$_DFFE_PP0P_  (.D(_0247_),
    .Q(\u_csr.addr_r[6] ),
    .RESET_B(_0098_),
    .CLK(clknet_3_4__leaf_spi_sclk_i));
 sky130_fd_sc_hd__dfrtp_1 \u_csr.bit_cnt[0]$_DFF_PP0_  (.D(_0009_),
    .Q(\u_csr.bit_cnt[0] ),
    .RESET_B(net56),
    .CLK(clknet_3_5__leaf_spi_sclk_i));
 sky130_fd_sc_hd__dfrtp_1 \u_csr.bit_cnt[1]$_DFF_PP0_  (.D(_0693_),
    .Q(\u_csr.bit_cnt[1] ),
    .RESET_B(net56),
    .CLK(clknet_3_5__leaf_spi_sclk_i));
 sky130_fd_sc_hd__dfrtp_1 \u_csr.bit_cnt[2]$_DFF_PP0_  (.D(_0001_),
    .Q(\u_csr.bit_cnt[2] ),
    .RESET_B(net56),
    .CLK(clknet_3_5__leaf_spi_sclk_i));
 sky130_fd_sc_hd__dfrtp_1 \u_csr.bit_cnt[3]$_DFF_PP0_  (.D(_0002_),
    .Q(\u_csr.bit_cnt[3] ),
    .RESET_B(net56),
    .CLK(clknet_3_5__leaf_spi_sclk_i));
 sky130_fd_sc_hd__dfrtp_1 \u_csr.c_auto_relock$_DFFE_PN0P_  (.D(_0252_),
    .Q(c_auto_relock),
    .RESET_B(net61),
    .CLK(clknet_4_11_0_refclk_i_regs));
 sky130_fd_sc_hd__dfrtp_1 \u_csr.c_bypass_sel$_DFFE_PN0P_  (.D(_0254_),
    .Q(c_bypass_sel),
    .RESET_B(net60),
    .CLK(clknet_4_2_0_refclk_i_regs));
 sky130_fd_sc_hd__dfrtp_1 \u_csr.c_clkout_en$_DFFE_PN0P_  (.D(_0256_),
    .Q(c_clkout_en),
    .RESET_B(net59),
    .CLK(clknet_4_2_0_refclk_i_regs));
 sky130_fd_sc_hd__dfrtp_1 \u_csr.c_cp_iset[0]$_DFFE_PN0P_  (.D(_0161_),
    .Q(net9),
    .RESET_B(net62),
    .CLK(clknet_4_13_0_refclk_i_regs));
 sky130_fd_sc_hd__dfrtp_1 \u_csr.c_cp_iset[1]$_DFFE_PN0P_  (.D(_0160_),
    .Q(net10),
    .RESET_B(net59),
    .CLK(clknet_4_10_0_refclk_i_regs));
 sky130_fd_sc_hd__dfrtp_1 \u_csr.c_cp_iset[2]$_DFFE_PN0P_  (.D(_0159_),
    .Q(net11),
    .RESET_B(net60),
    .CLK(clknet_4_2_0_refclk_i_regs));
 sky130_fd_sc_hd__dfrtp_1 \u_csr.c_cp_iset[3]$_DFFE_PN0P_  (.D(_0158_),
    .Q(net12),
    .RESET_B(core_rst_n),
    .CLK(clknet_4_1_0_refclk_i_regs));
 sky130_fd_sc_hd__dfrtp_1 \u_csr.c_cp_iset[4]$_DFFE_PN0P_  (.D(_0157_),
    .Q(net13),
    .RESET_B(net59),
    .CLK(clknet_4_11_0_refclk_i_regs));
 sky130_fd_sc_hd__dfrtp_1 \u_csr.c_cp_iset[5]$_DFFE_PN0P_  (.D(_0156_),
    .Q(net14),
    .RESET_B(net62),
    .CLK(clknet_4_13_0_refclk_i_regs));
 sky130_fd_sc_hd__dfrtp_1 \u_csr.c_cp_iset[6]$_DFFE_PN0P_  (.D(_0155_),
    .Q(net15),
    .RESET_B(net62),
    .CLK(clknet_4_13_0_refclk_i_regs));
 sky130_fd_sc_hd__dfstp_2 \u_csr.c_cp_iset[7]$_DFFE_PN1P_  (.D(_0240_),
    .Q(net16),
    .SET_B(net60),
    .CLK(clknet_4_2_0_refclk_i_regs));
 sky130_fd_sc_hd__dfrtp_1 \u_csr.c_en_cp_man$_DFFE_PN0P_  (.D(_0244_),
    .Q(c_en_cp_man),
    .RESET_B(net59),
    .CLK(clknet_4_9_0_refclk_i_regs));
 sky130_fd_sc_hd__dfrtp_1 \u_csr.c_en_vco_man$_DFFE_PN0P_  (.D(_0246_),
    .Q(c_en_vco_man),
    .RESET_B(net59),
    .CLK(clknet_4_10_0_refclk_i_regs));
 sky130_fd_sc_hd__dfrtp_1 \u_csr.c_en_vreg_man$_DFFE_PN0P_  (.D(_0249_),
    .Q(c_en_vreg_man),
    .RESET_B(net59),
    .CLK(clknet_4_9_0_refclk_i_regs));
 sky130_fd_sc_hd__dfrtp_1 \u_csr.c_lockw[0]$_DFFE_PN0P_  (.D(_0147_),
    .Q(\c_lockw[0] ),
    .RESET_B(net61),
    .CLK(clknet_4_3_0_refclk_i_regs));
 sky130_fd_sc_hd__dfrtp_1 \u_csr.c_lockw[1]$_DFFE_PN0P_  (.D(_0146_),
    .Q(\c_lockw[1] ),
    .RESET_B(net60),
    .CLK(clknet_4_3_0_refclk_i_regs));
 sky130_fd_sc_hd__dfrtp_1 \u_csr.c_lockw[2]$_DFFE_PN0P_  (.D(_0145_),
    .Q(\c_lockw[2] ),
    .RESET_B(net60),
    .CLK(clknet_4_2_0_refclk_i_regs));
 sky130_fd_sc_hd__dfrtp_1 \u_csr.c_lockw[3]$_DFFE_PN0P_  (.D(_0144_),
    .Q(\c_lockw[3] ),
    .RESET_B(net60),
    .CLK(clknet_4_3_0_refclk_i_regs));
 sky130_fd_sc_hd__dfrtp_1 \u_csr.c_lockw[4]$_DFFE_PN0P_  (.D(_0143_),
    .Q(\c_lockw[4] ),
    .RESET_B(net61),
    .CLK(clknet_4_9_0_refclk_i_regs));
 sky130_fd_sc_hd__dfstp_2 \u_csr.c_lockw[5]$_DFFE_PN1P_  (.D(_0142_),
    .Q(\c_lockw[5] ),
    .SET_B(net61),
    .CLK(clknet_4_12_0_refclk_i_regs));
 sky130_fd_sc_hd__dfrtp_1 \u_csr.c_lockw[6]$_DFFE_PN0P_  (.D(_0141_),
    .Q(\c_lockw[6] ),
    .RESET_B(net61),
    .CLK(clknet_4_9_0_refclk_i_regs));
 sky130_fd_sc_hd__dfrtp_1 \u_csr.c_lockw[7]$_DFFE_PN0P_  (.D(_0238_),
    .Q(\c_lockw[7] ),
    .RESET_B(net60),
    .CLK(clknet_4_2_0_refclk_i_regs));
 sky130_fd_sc_hd__dfrtp_1 \u_csr.c_m_div[0]$_DFFE_PN0P_  (.D(_0177_),
    .Q(net22),
    .RESET_B(net60),
    .CLK(clknet_4_8_0_refclk_i_regs));
 sky130_fd_sc_hd__dfstp_2 \u_csr.c_m_div[1]$_DFFE_PN1P_  (.D(_0176_),
    .Q(net23),
    .SET_B(net60),
    .CLK(clknet_4_8_0_refclk_i_regs));
 sky130_fd_sc_hd__dfrtp_1 \u_csr.c_m_div[2]$_DFFE_PN0P_  (.D(_0175_),
    .Q(net24),
    .RESET_B(net60),
    .CLK(clknet_4_2_0_refclk_i_regs));
 sky130_fd_sc_hd__dfstp_2 \u_csr.c_m_div[3]$_DFFE_PN1P_  (.D(_0174_),
    .Q(net25),
    .SET_B(net59),
    .CLK(clknet_4_10_0_refclk_i_regs));
 sky130_fd_sc_hd__dfrtp_1 \u_csr.c_m_div[4]$_DFFE_PN0P_  (.D(_0173_),
    .Q(net26),
    .RESET_B(net59),
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
 sky130_fd_sc_hd__dfrtp_1 \u_csr.r_test[3]$_DFFE_PN0P_  (.D(_0137_),
    .Q(\u_csr.r_test[3] ),
    .RESET_B(net59),
    .CLK(clknet_3_3__leaf_spi_sclk_i));
 sky130_fd_sc_hd__dfrtp_1 \u_csr.r_test[4]$_DFFE_PN0P_  (.D(_0136_),
    .Q(\u_csr.r_test[4] ),
    .RESET_B(net59),
    .CLK(clknet_3_7__leaf_spi_sclk_i));
 sky130_fd_sc_hd__dfrtp_1 \u_csr.r_test[5]$_DFFE_PN0P_  (.D(_0135_),
    .Q(\u_csr.r_test[5] ),
    .RESET_B(net59),
    .CLK(clknet_3_4__leaf_spi_sclk_i));
 sky130_fd_sc_hd__dfrtp_1 \u_csr.r_test[6]$_DFFE_PN0P_  (.D(_0134_),
    .Q(\u_csr.r_test[6] ),
    .RESET_B(net59),
    .CLK(clknet_3_1__leaf_spi_sclk_i));
 sky130_fd_sc_hd__dfrtp_1 \u_csr.r_test[7]$_DFFE_PN0P_  (.D(_0237_),
    .Q(\u_csr.r_test[7] ),
    .RESET_B(net59),
    .CLK(clknet_3_1__leaf_spi_sclk_i));
 sky130_fd_sc_hd__dfrtp_1 \u_csr.r_vcobnd[0]$_DFFE_PN0P_  (.D(_0204_),
    .Q(\u_csr.r_vcobnd[0] ),
    .RESET_B(net61),
    .CLK(clknet_3_2__leaf_spi_sclk_i));
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
