NavinSiHive/Paper-to-Chip/(commit log)

2026-07-02 Initial release: sky130 dual-control ring-oscillator PLL chip — GDS (compressed), SystemVerilog + RNM models, signoff docs
    [pll_top_postlayout.sv, pll_top_prelayout.sv, pll_top_rnm.sv, tb_pll_top.sv]
2026-07-04 Add lock-detect verification report (CK_DIV40 detector, 76-check regression, SPI cold-start finding) to reports/lock_detect
2026-07-04 Lock detect INTEGRATED into canonical core + SPI cold-start fix; target PLLTOP4_D40; 4-suite/101-check regression all pass
2026-07-04 v3 chip: PLLTOP4_D40 + freq-lock pll_dcc — TAPEOUT-READY (route-DRC0, LVS match, formal DRC0, antenna0, filled). On-chip LOCK detect shipped. Refresh GDS/snapshot/banner/signoff.
2026-07-04 Kit polish: VCO range 100-300MHz (all docs+banner), post-layout rides table, annotated TT lock-witness, schematics/+symbols/ (full analog design), contact assist@si-hive.com
    [BIASCP.sch, BIASGM.sch, BIASREG.sch, CAPBANK_C1.sch, CAPBANK_GM.sch, CAPBANK_VVCO.sch, CP.sch, DualCtrlVCO.sch]
2026-07-04 v4 FINAL chip: C2-final frozen-footprint PLLTOP4_D40 drop-in (TAPEOUT-READY: LEF-identical, formal DRC 0, LVS match, antenna 0) + refreshed images (pll_chip/PLLTOP4_D40/pll_dcc), GDS refreshed to v4
2026-07-04 Analog figure: light-bg + tight crop, no port callouts (single PLLTOP4_D40); period jitter; Si-Hive; remove 'tapeout-ready' everywhere; regen banner+snapshot
2026-07-04 gds/: replace stale PLLTOP with PLLTOP4_D40 + add PLLTOP4 + PLLTOP_AnaCore (blog lockstep); 3-figure analog section (AnaCore→PLLTOP4→D40); remove RMS/thermal jitter everywhere (docs/models/images); m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
    [pll_top_postlayout.sv, pll_top_prelayout.sv, tb_pll_top.sv]
